GitForEng/syncbox/Design/Firmware/PIC24 Firmware/LCD Firmware/xaml design/XamlDesign/assets/actuator.jpg

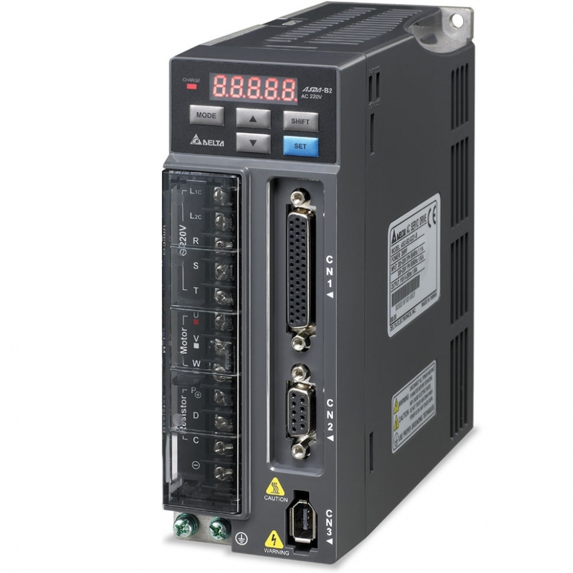
Design/Firmware/PIC24 Firmware/LCD Firmware/xaml design/XamlDesign/assets/actuator.jpg
