GitForEng/syncbox/Design/Firmware/PIC24 Firmware/documents/Doxygen/images/componentdiagram.png

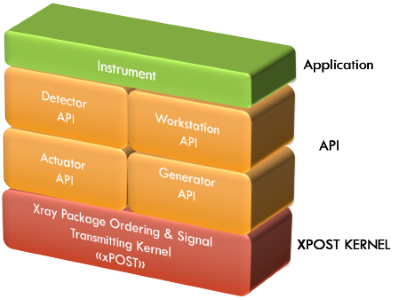
Design/Firmware/PIC24 Firmware/documents/Doxygen/images/componentdiagram.png
