GitForEng/syncbox/Design/SYNCBOX.PcbDoc.htm

Reporting Options

# File in Previous Format

Date | : | 4/13/2021
Time | : | 9:07:22 AM
Filename | : | D:\embedded_systems\Projects\BogaziciUniversity\syncbox\Design\SYNCBOX.PcbDoc

Version | Warning

This file was generated by an earlier version of the software
