GitForEng/syncbox/Artifacts/Reports/SyncBox/schematic.bmp

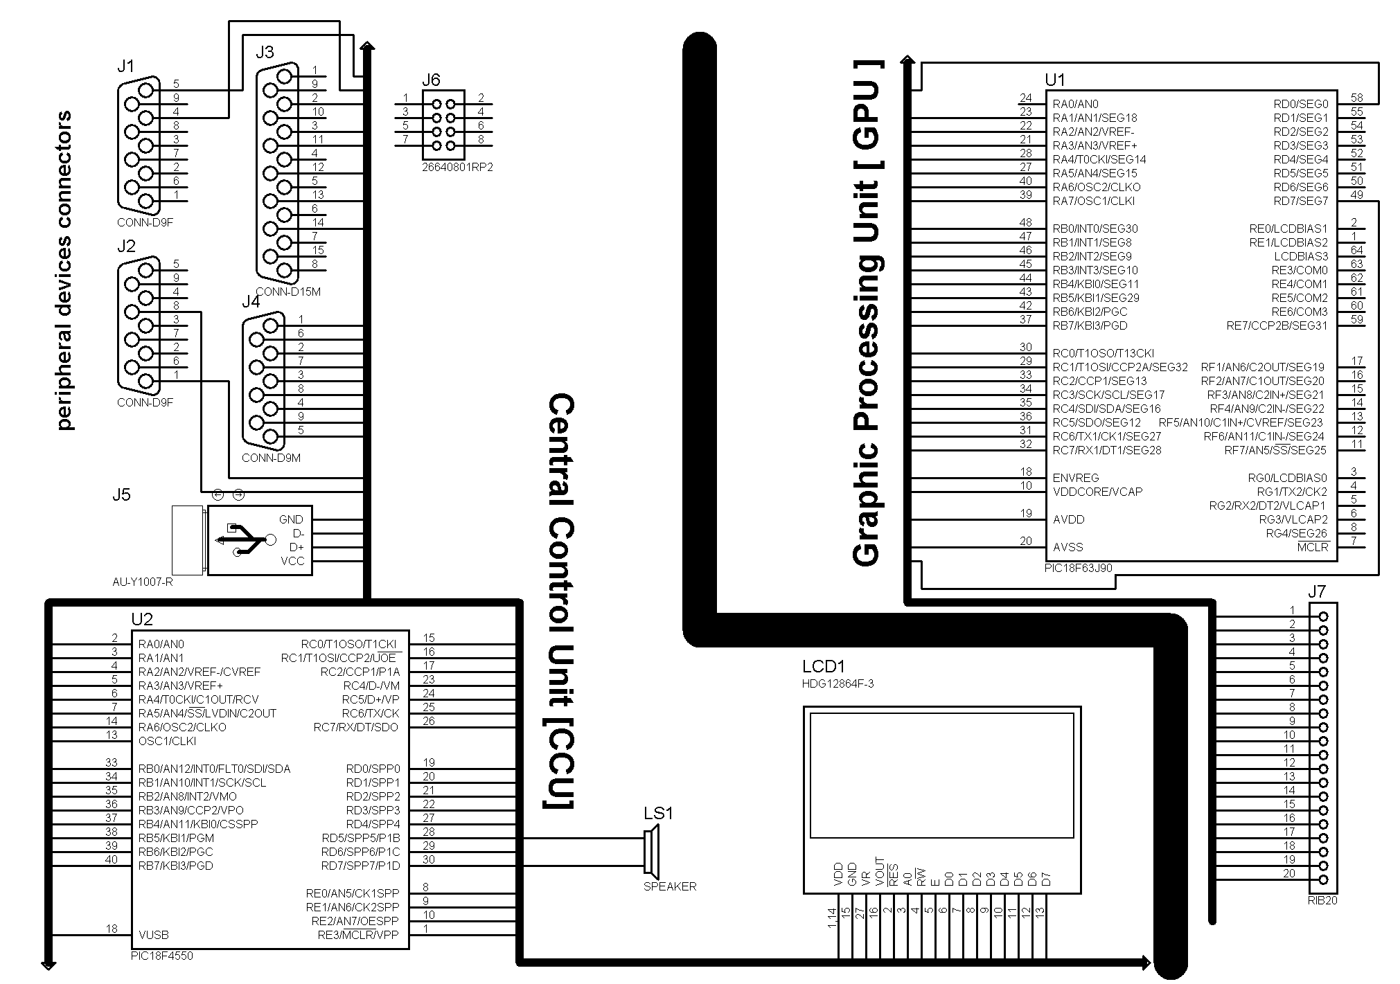
Artifacts/Reports/SyncBox/schematic.bmp
