GitForEng/syncbox/Artifacts/Reports/SyncBox/SyncBox Activity Diagram.jpg

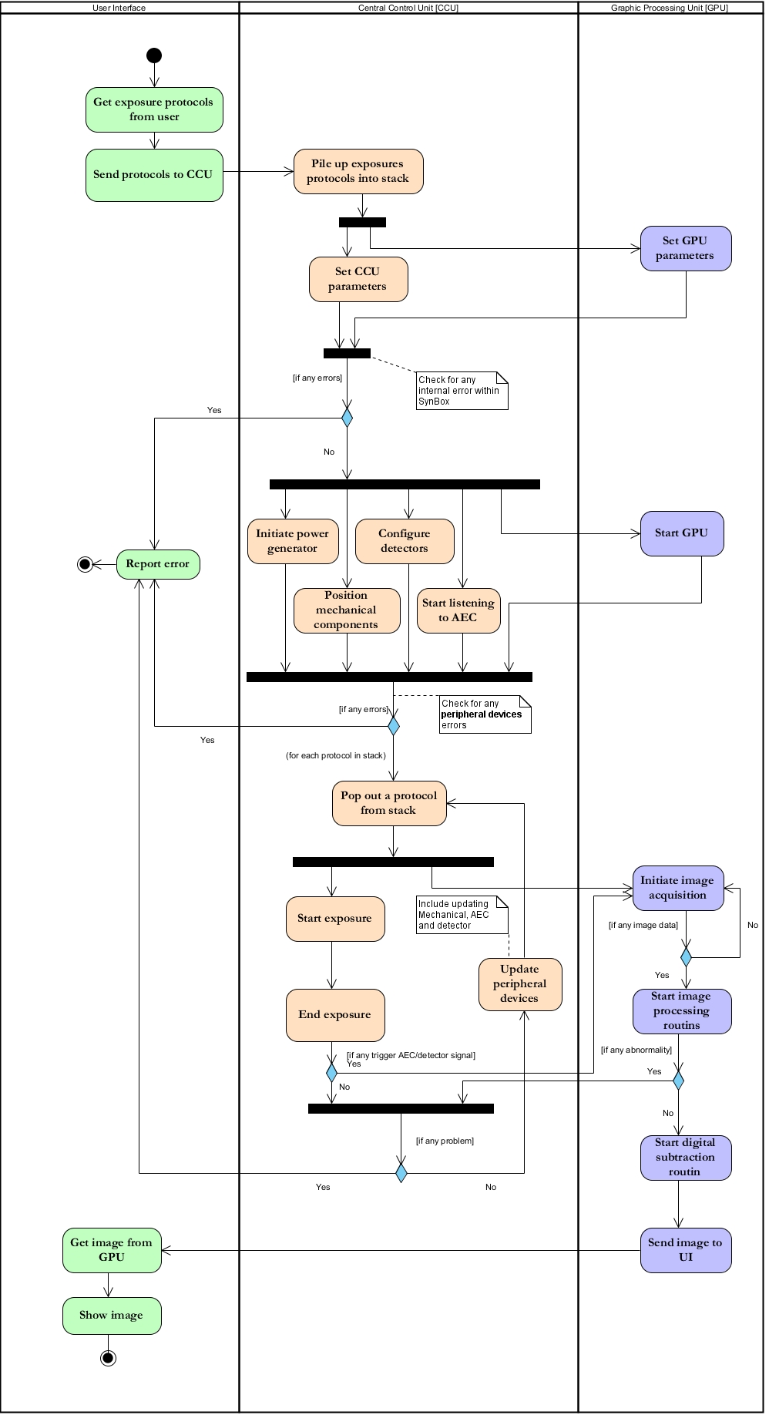
Artifacts/Reports/SyncBox/SyncBox Activity Diagram.jpg
