GitForEng/syncbox/Artifacts/Reports/SyncBox/SyncBox Sequence Diagram.jpg

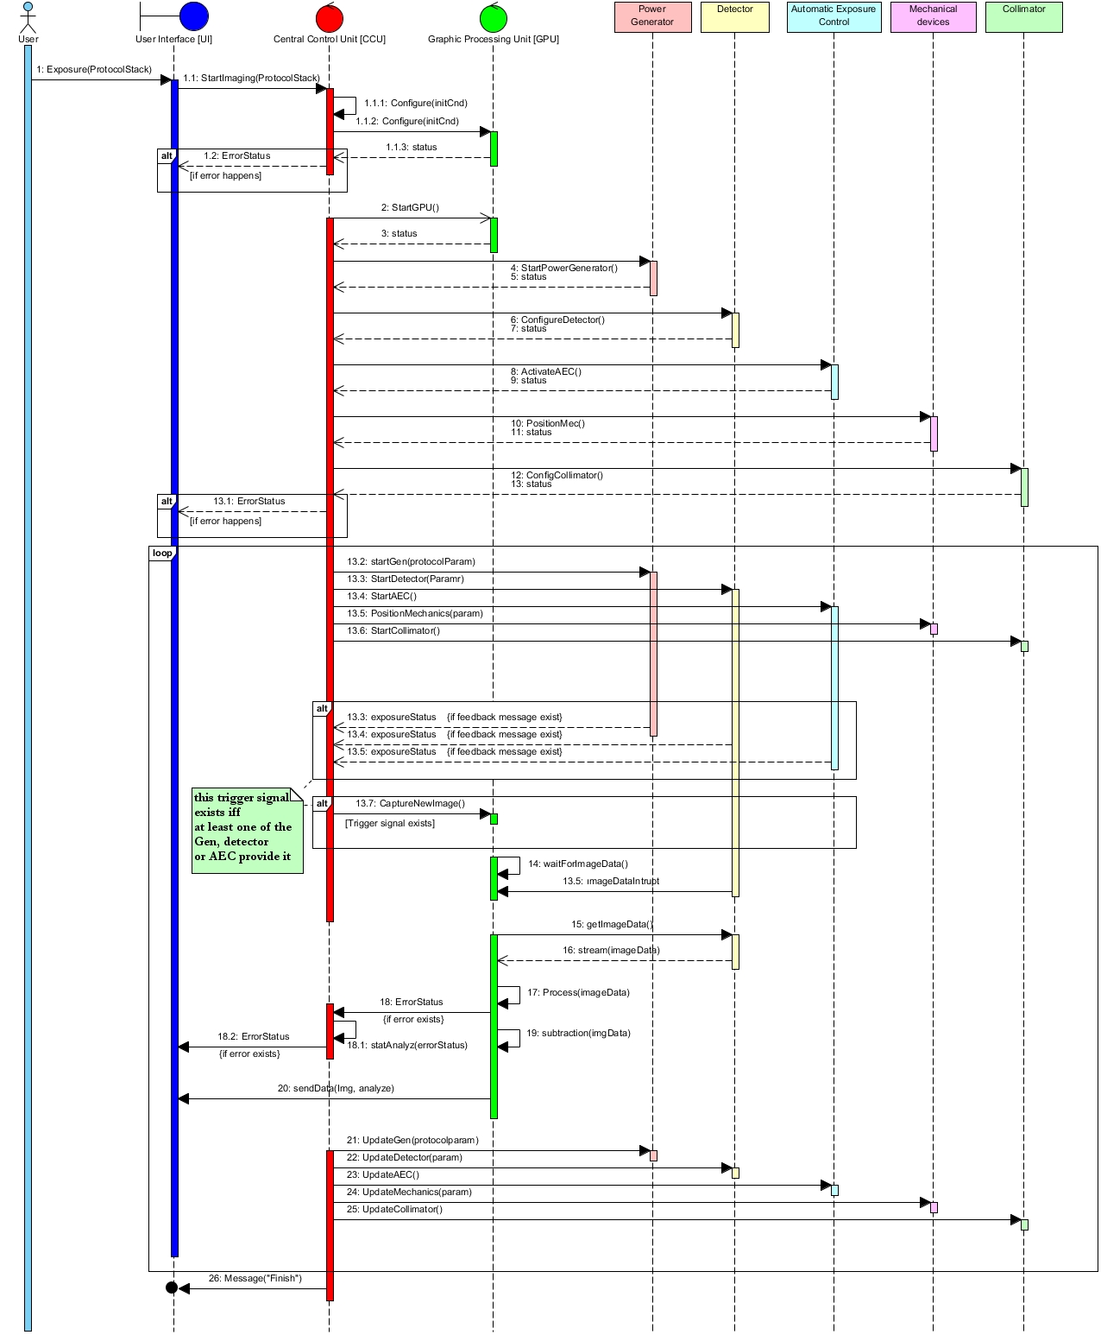
Artifacts/Reports/SyncBox/SyncBox Sequence Diagram.jpg
