GitForEng/syncbox/Design/Firmware/PIC24 Firmware/documents/docbook/_connection_map_8h__dep__incl.png

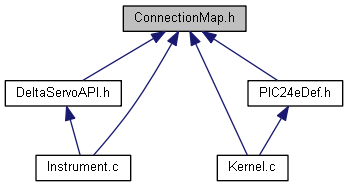
Design/Firmware/PIC24 Firmware/documents/docbook/_connection_map_8h__dep__incl.png
