GitForEng/syncbox/Design/Firmware/PIC24 Firmware/documents/docbook/_delta_servo_a_p_i_8c__incl.png

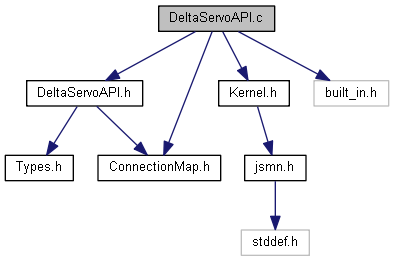
Design/Firmware/PIC24 Firmware/documents/docbook/_delta_servo_a_p_i_8c__incl.png
