GitForEng/syncbox/Design/Firmware/PIC24 Firmware/documents/docbook/_instrument_8c__incl.png

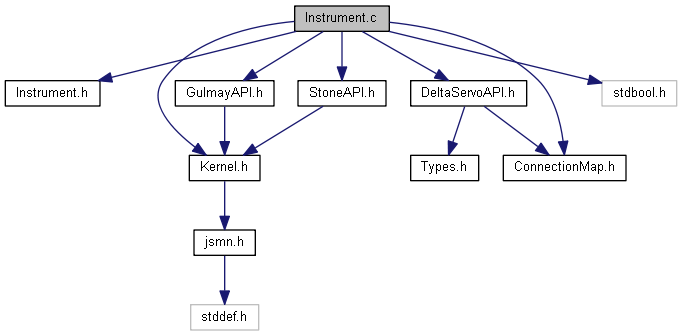
Design/Firmware/PIC24 Firmware/documents/docbook/_instrument_8c__incl.png
