GitForEng/syncbox/Design/Firmware/PIC24 Firmware/documents/docbook/_kernel_8c__incl.png

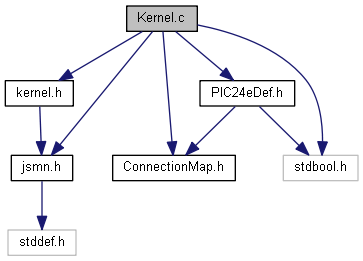
Design/Firmware/PIC24 Firmware/documents/docbook/_kernel_8c__incl.png
