GitForEng/syncbox/Design/Firmware/PIC24 Firmware/documents/docbook/_types_8h__dep__incl.png

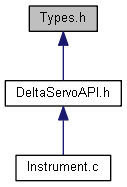
Design/Firmware/PIC24 Firmware/documents/docbook/_types_8h__dep__incl.png
