GitForEng/syncbox/Design/Firmware/PIC24 Firmware/documents/docbook/jsmn_8h__dep__incl.png

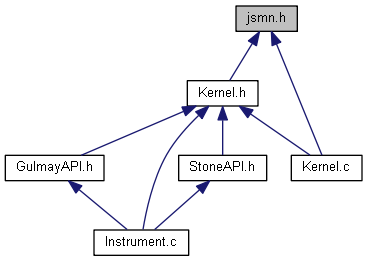
Design/Firmware/PIC24 Firmware/documents/docbook/jsmn_8h__dep__incl.png
