GitForEng/syncbox/Design/Firmware/PIC24 Firmware/documents/docbook/main_8c__incl.png

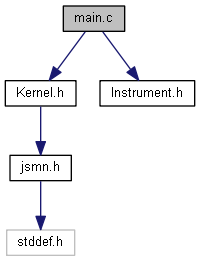
Design/Firmware/PIC24 Firmware/documents/docbook/main_8c__incl.png
