GitForEng/syncbox/Design/Firmware/PIC24 Firmware/documents/docbook/struct_d_e_v_i_c_e___s_l_o_t__coll__graph.png

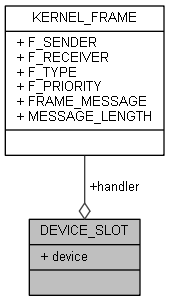
Design/Firmware/PIC24 Firmware/documents/docbook/struct_d_e_v_i_c_e___s_l_o_t__coll__graph.png
