GitForEng/syncbox/Design/Firmware/PIC24 Firmware/documents/docbook/struct_g_e_n___s_t_a_t_e__coll__graph.png

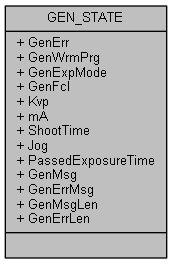
Design/Firmware/PIC24 Firmware/documents/docbook/struct_g_e_n___s_t_a_t_e__coll__graph.png
