GitForEng/syncbox/Design/Firmware/PIC24 Firmware/documents/docbook/struct_k_e_r_n_e_l___f_r_a_m_e__coll__graph.png

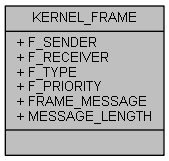
Design/Firmware/PIC24 Firmware/documents/docbook/struct_k_e_r_n_e_l___f_r_a_m_e__coll__graph.png
