GitForEng/syncbox/Design/Firmware/PIC24 Firmware/documents/docbook/tst_instrument_8c__incl.png

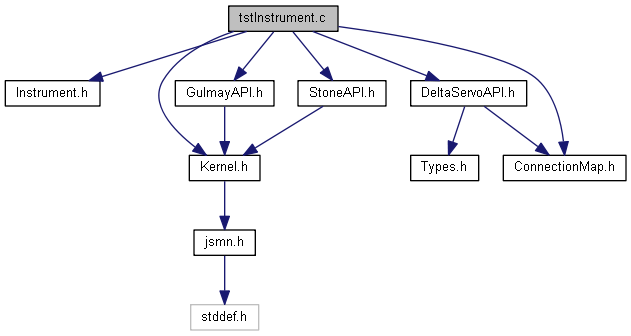
Design/Firmware/PIC24 Firmware/documents/docbook/tst_instrument_8c__incl.png
