GitForEng/syncbox/Design/Firmware/PIC24 Firmware/documents/Doxygen/html/graph_legend.png

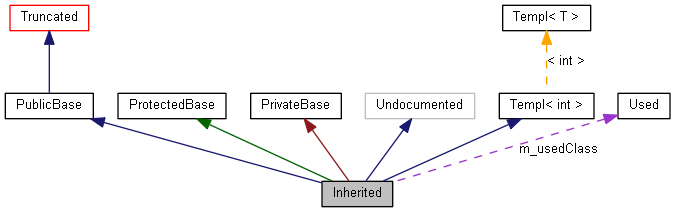
Design/Firmware/PIC24 Firmware/documents/Doxygen/html/graph_legend.png
