GitForEng/syncbox/Design/Firmware/PIC24 Firmware/documents/visual paradigm/pictures/Bootup Activity Diagram.jpg

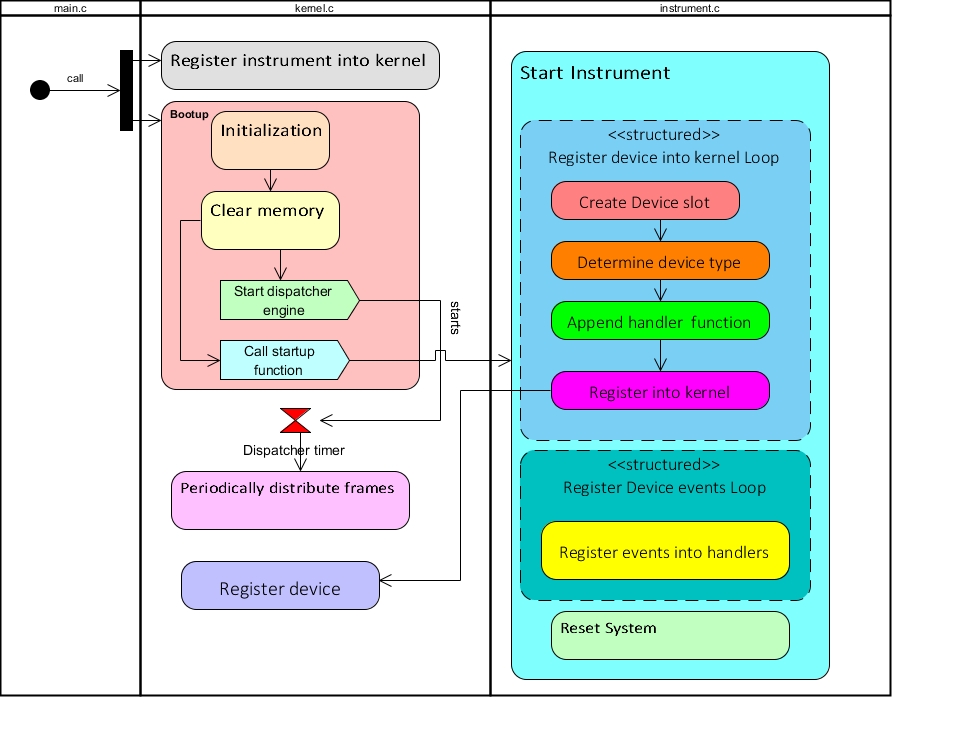
Design/Firmware/PIC24 Firmware/documents/visual paradigm/pictures/Bootup Activity Diagram.jpg
