GitForEng/syncbox/Design/Firmware/PIC24 Firmware/documents/visual paradigm/pictures/Button Pressed Communication Diagram.jpg

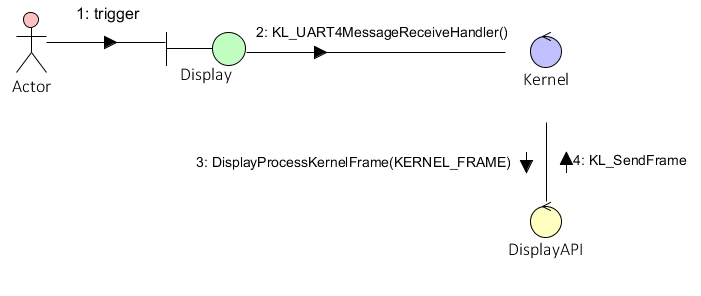
Design/Firmware/PIC24 Firmware/documents/visual paradigm/pictures/Button Pressed Communication Diagram.jpg
