GitForEng/syncbox/Design/Firmware/PIC24 Firmware/documents/visual paradigm/pictures/Instrument Feedback Communication  Diagram.jpg

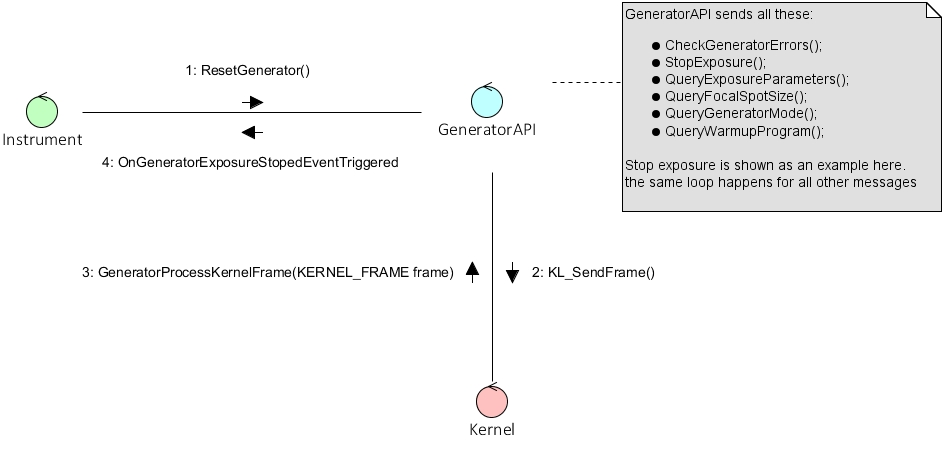
Design/Firmware/PIC24 Firmware/documents/visual paradigm/pictures/Instrument Feedback Communication Diagram.jpg
