GitForEng/syncbox/Design/Firmware/PIC24 Firmware/documents/visual paradigm/pictures/Instrument Start Exposure Activity Diagram.jpg

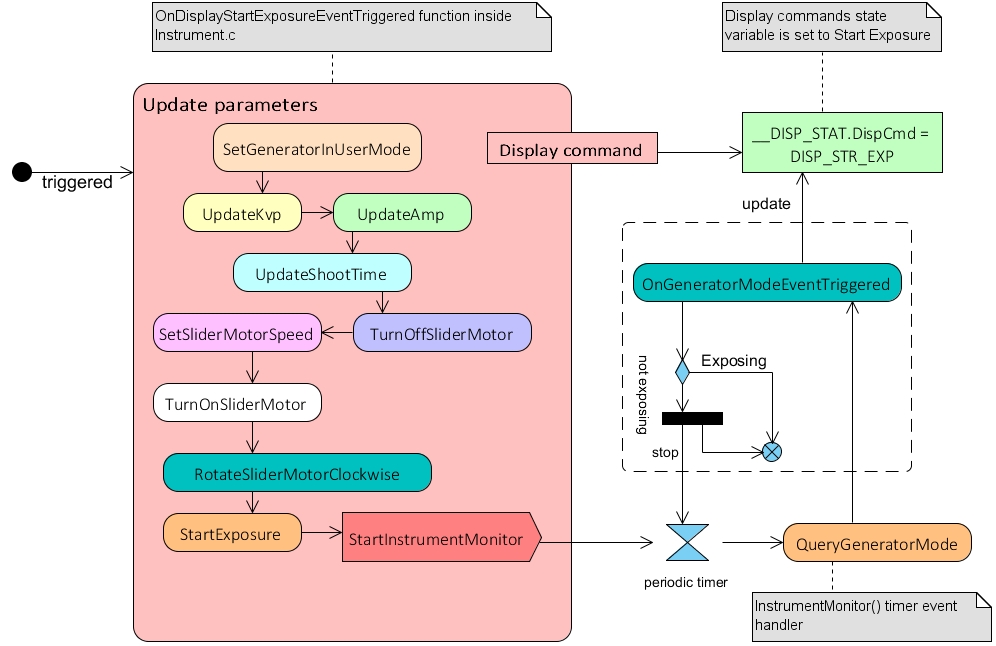
Design/Firmware/PIC24 Firmware/documents/visual paradigm/pictures/Instrument Start Exposure Activity Diagram.jpg
