GitForEng/syncbox/Design/Firmware/PIC24 Firmware/documents/visual paradigm/pictures/Instrument State Diagram.jpg

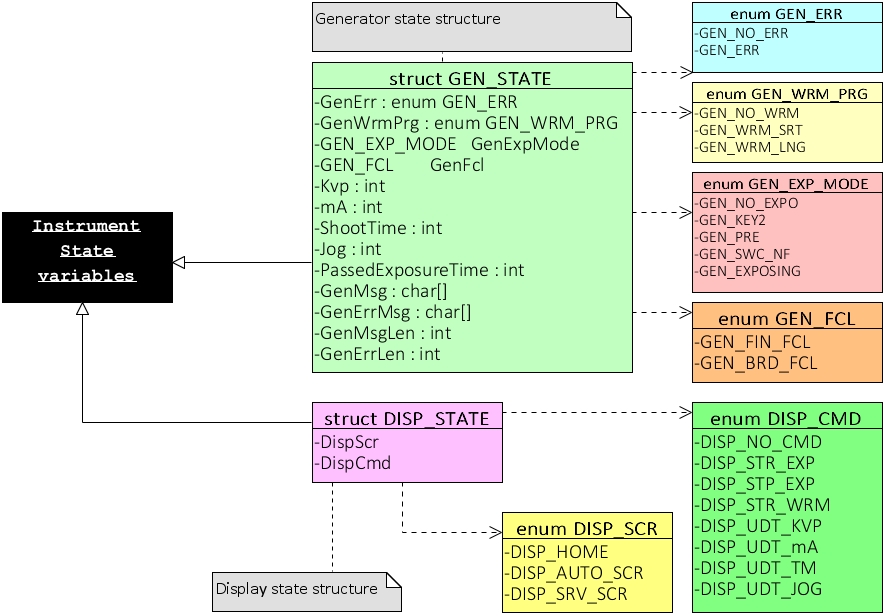
Design/Firmware/PIC24 Firmware/documents/visual paradigm/pictures/Instrument State Diagram.jpg
