GitForEng/syncbox/Design/Firmware/PIC24 Firmware/documents/visual paradigm/pictures/Start Exposure Sequence Diagram.jpg

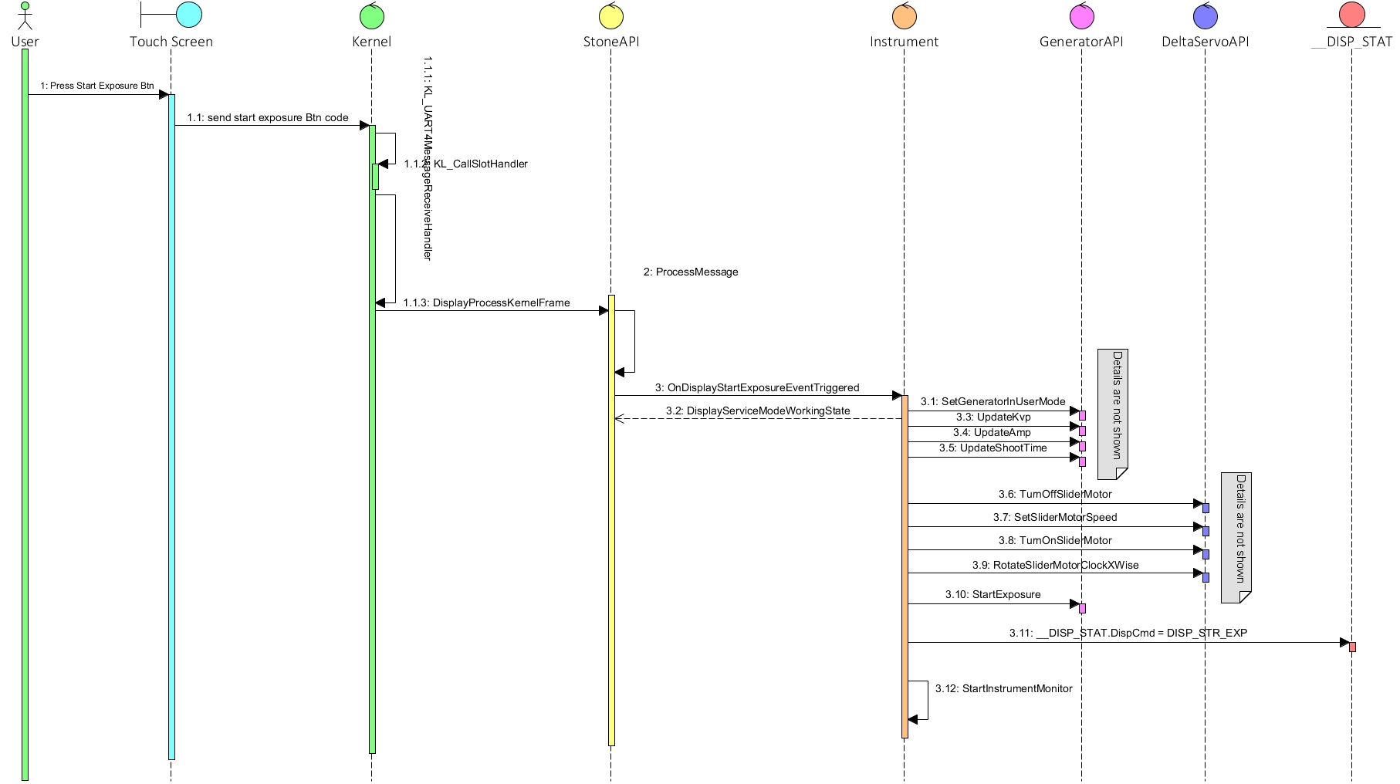
Design/Firmware/PIC24 Firmware/documents/visual paradigm/pictures/Start Exposure Sequence Diagram.jpg
