GitForEng/syncbox/Design/Firmware/PIC24 Firmware/firmware/easypic-fusion-v7-pic24ep512gu810-thickbox_default-12x.jpg

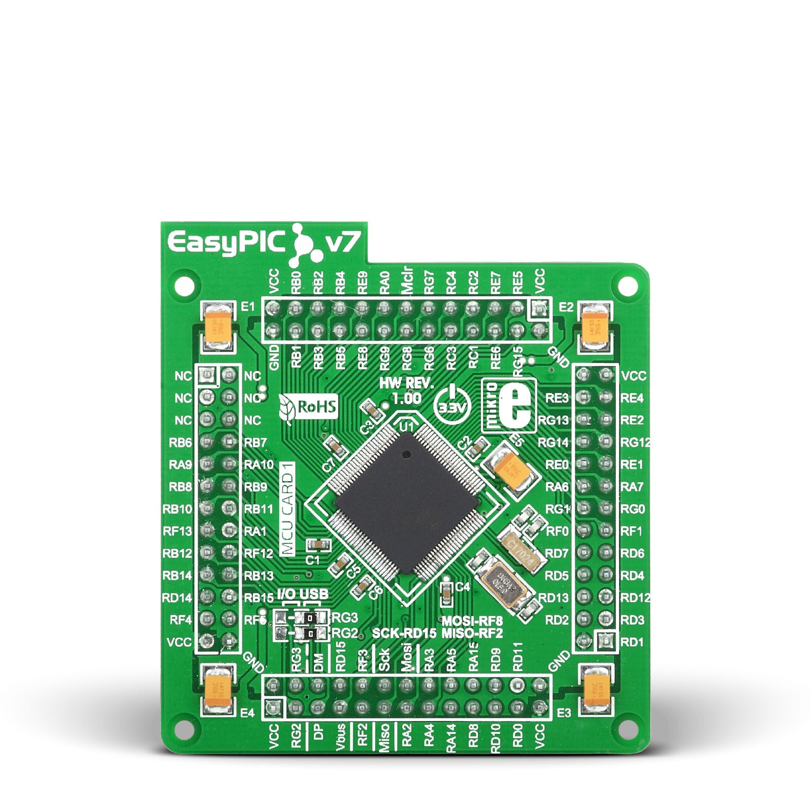
Design/Firmware/PIC24 Firmware/firmware/easypic-fusion-v7-pic24ep512gu810-thickbox_default-12x.jpg
