GitForEng/syncbox/Design/Firmware/PIC24 Firmware/firmware/json-parser-functioncall.JPG

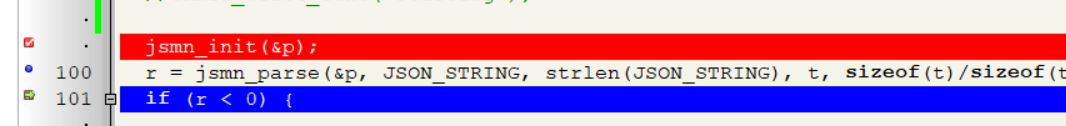
Design/Firmware/PIC24 Firmware/firmware/json-parser-functioncall.JPG
