GitForEng/syncbox/Design/Firmware/PIC24 Firmware/firmware/PIC24E_Pinout.png

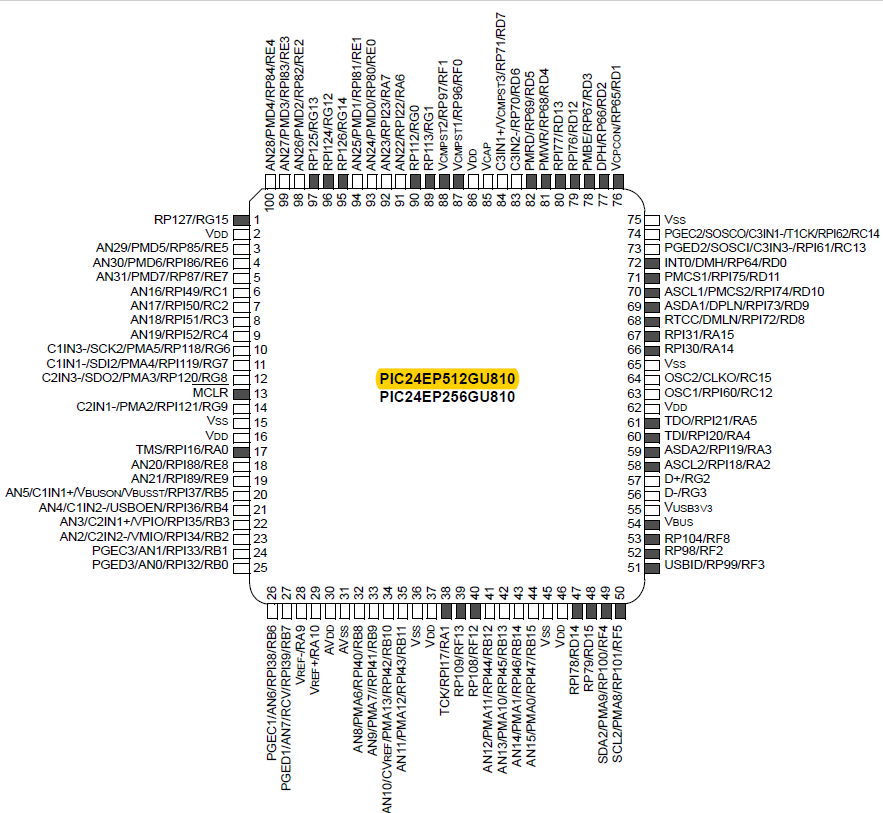
Design/Firmware/PIC24 Firmware/firmware/PIC24E_Pinout.png
