GitForEng/syncbox/Design/Firmware/PIC24 Firmware/firmware/project-config-screenshot.JPG

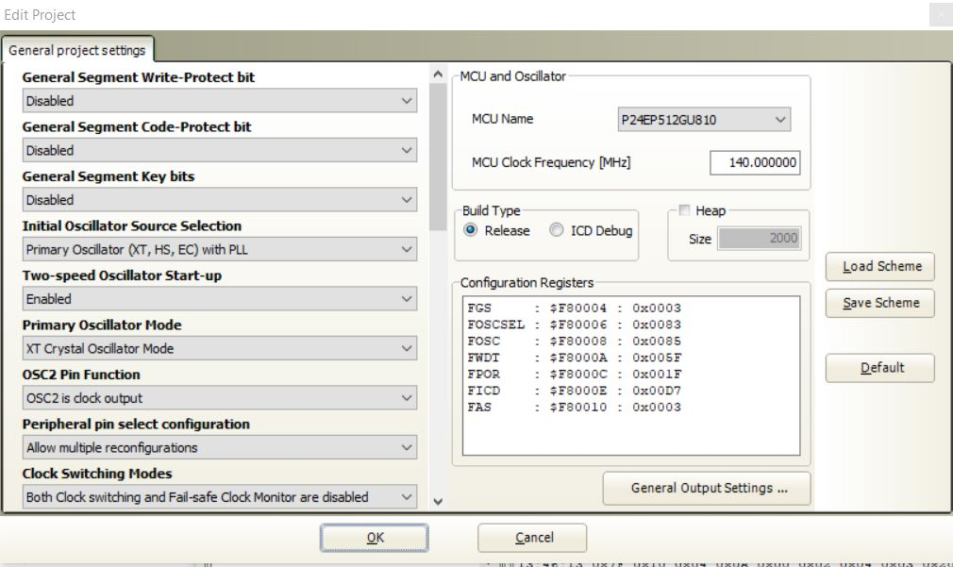
Design/Firmware/PIC24 Firmware/firmware/project-config-screenshot.JPG
