GitForEng/syncbox/Design/Firmware/PIC24 Firmware/LCD Firmware/project/00.bmp

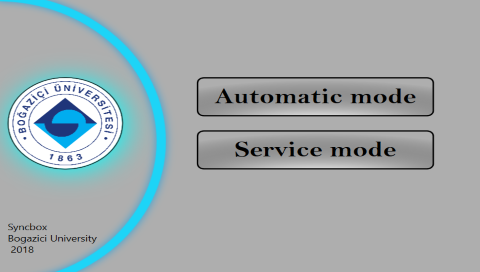
Design/Firmware/PIC24 Firmware/LCD Firmware/project/00.bmp
