GitForEng/syncbox/Design/Firmware/PIC24 Firmware/LCD Firmware/project/01.bmp

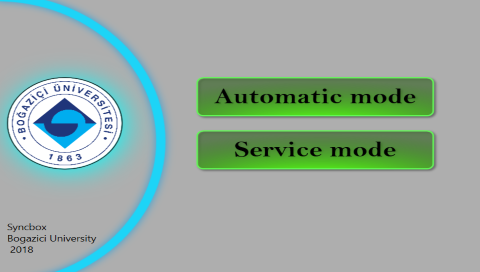
Design/Firmware/PIC24 Firmware/LCD Firmware/project/01.bmp
