GitForEng/syncbox/Design/Firmware/PIC24 Firmware/LCD Firmware/project/02.bmp

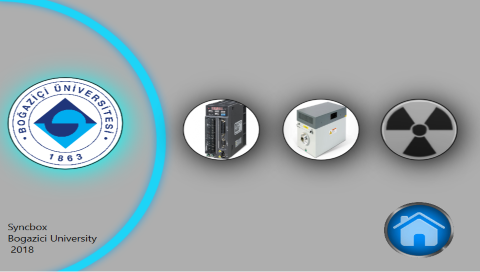
Design/Firmware/PIC24 Firmware/LCD Firmware/project/02.bmp
