GitForEng/syncbox/Design/Firmware/PIC24 Firmware/LCD Firmware/project/04.bmp

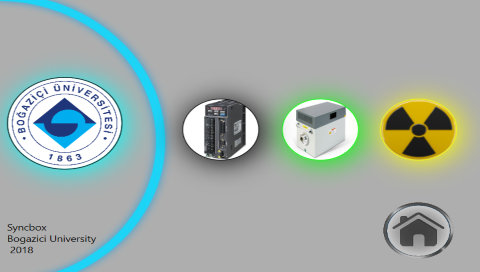
Design/Firmware/PIC24 Firmware/LCD Firmware/project/04.bmp
