GitForEng/syncbox/Design/Firmware/PIC24 Firmware/LCD Firmware/project/06.bmp

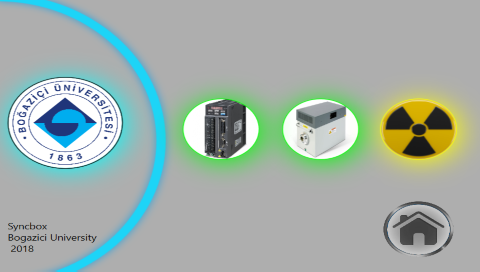
Design/Firmware/PIC24 Firmware/LCD Firmware/project/06.bmp
