GitForEng/syncbox/Design/Firmware/PIC24 Firmware/LCD Firmware/project/07.bmp

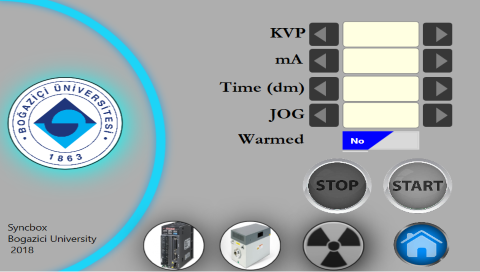
Design/Firmware/PIC24 Firmware/LCD Firmware/project/07.bmp
