GitForEng/syncbox/Design/Firmware/PIC24 Firmware/LCD Firmware/project/10.bmp

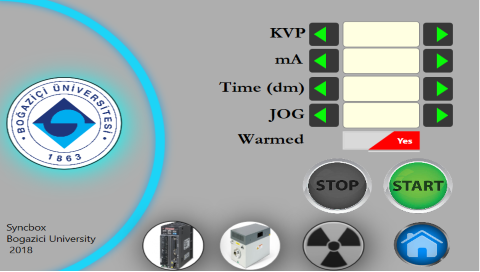
Design/Firmware/PIC24 Firmware/LCD Firmware/project/10.bmp
