GitForEng/syncbox/Design/Firmware/PIC24 Firmware/LCD Firmware/xaml design/XamlDesign/assets/bu.png

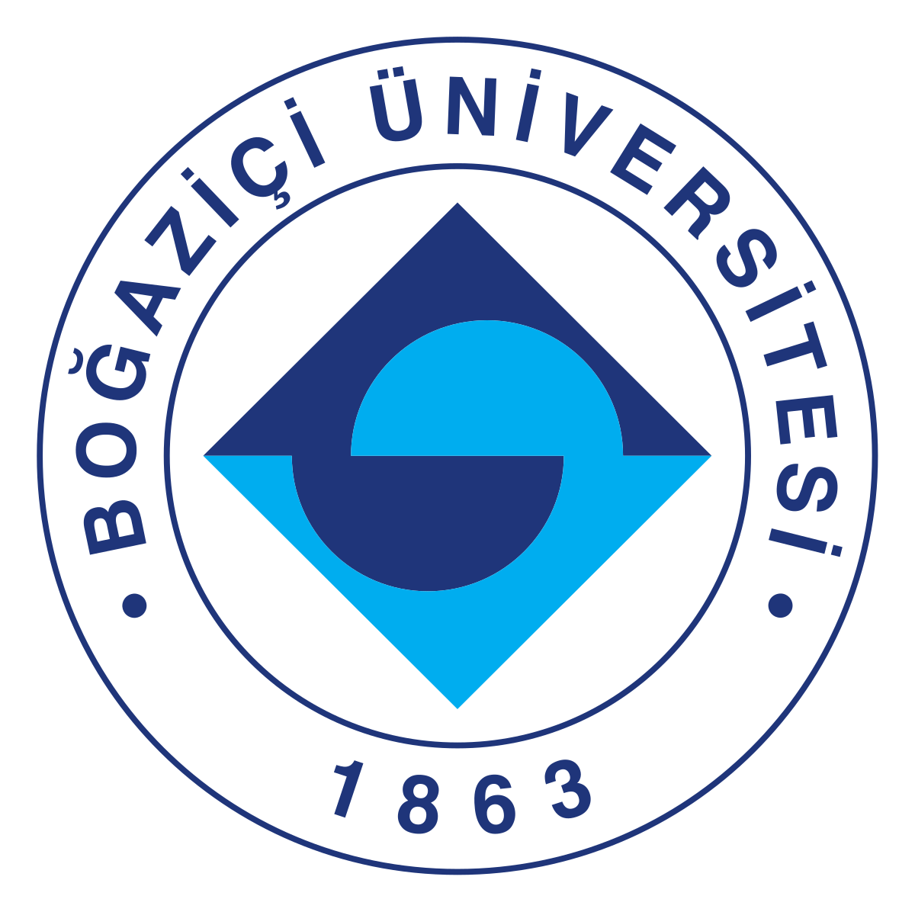
Design/Firmware/PIC24 Firmware/LCD Firmware/xaml design/XamlDesign/assets/bu.png
