GitForEng/syncbox/Design/Firmware/PIC24 Firmware/LCD Firmware/xaml design/XamlDesign/assets/detector.jpg

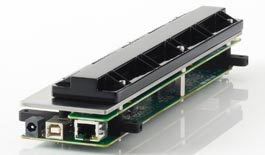
Design/Firmware/PIC24 Firmware/LCD Firmware/xaml design/XamlDesign/assets/detector.jpg
