GitForEng/syncbox/Design/Firmware/PIC24 Firmware/LCD Firmware/xaml design/XamlDesign/assets/generator.jpg

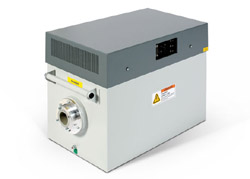
Design/Firmware/PIC24 Firmware/LCD Firmware/xaml design/XamlDesign/assets/generator.jpg
