GitForEng/syncbox/Design/Firmware/PIC24 Firmware/LCD Firmware/xaml design/XamlDesign/Resources/diactivehome.png

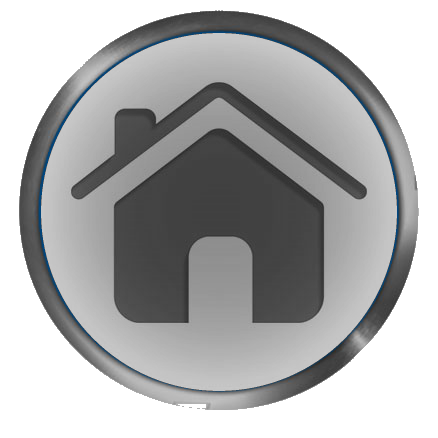
Design/Firmware/PIC24 Firmware/LCD Firmware/xaml design/XamlDesign/Resources/diactivehome.png
