GitForEng/syncbox/Design/Firmware/PIC24 Firmware/LCD Firmware/xaml design/XamlDesign/Resources/diactivestart.png

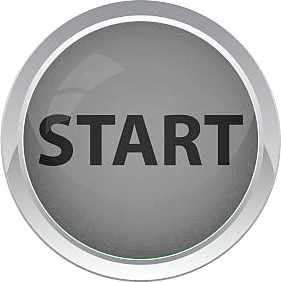
Design/Firmware/PIC24 Firmware/LCD Firmware/xaml design/XamlDesign/Resources/diactivestart.png
