GitForEng/syncbox/Design/Firmware/PIC24 Firmware/LCD Firmware/xaml design/XamlDesign/Resources/diactivestop.png

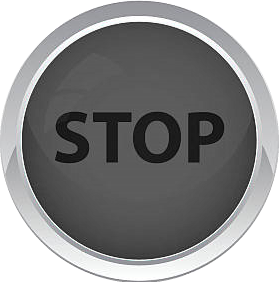
Design/Firmware/PIC24 Firmware/LCD Firmware/xaml design/XamlDesign/Resources/diactivestop.png
