GitForEng/syncbox/Design/Firmware/PIC24 Firmware/LCD Firmware/xaml design/XamlDesign/Resources/home.png

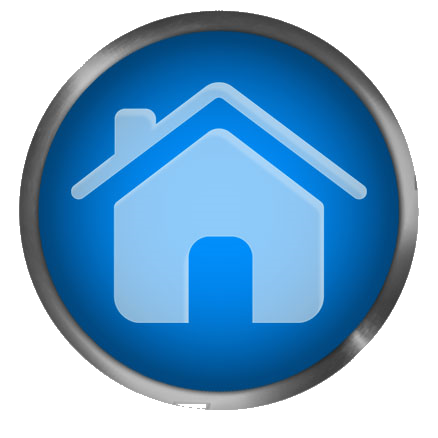
Design/Firmware/PIC24 Firmware/LCD Firmware/xaml design/XamlDesign/Resources/home.png
