GitForEng/syncbox/Design/Firmware/PIC24 Firmware/LCD Firmware/xaml design/XamlDesign/Resources/start.jpg

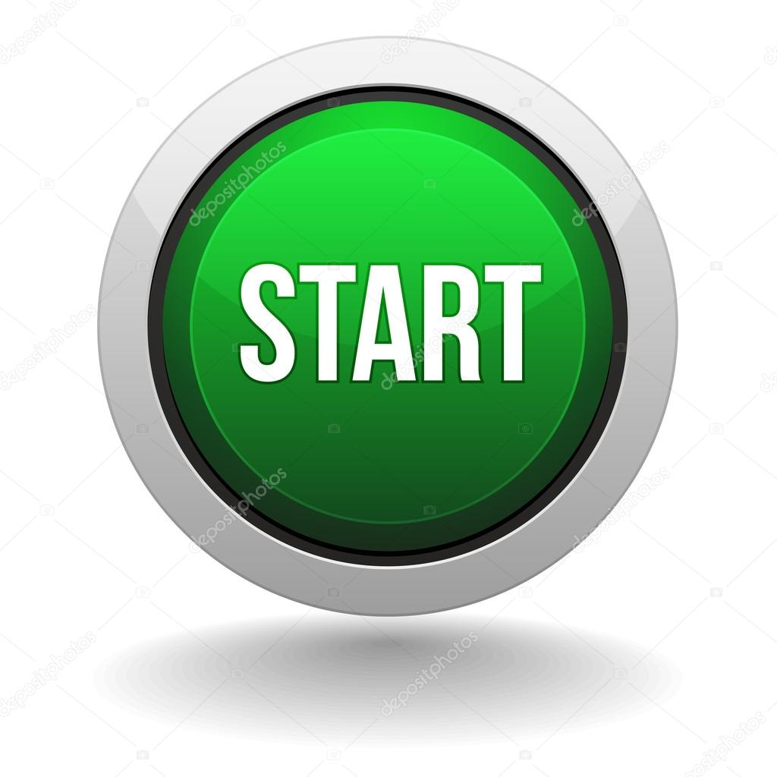
Design/Firmware/PIC24 Firmware/LCD Firmware/xaml design/XamlDesign/Resources/start.jpg
