GitForEng/syncbox/Design/SMASeries.stp

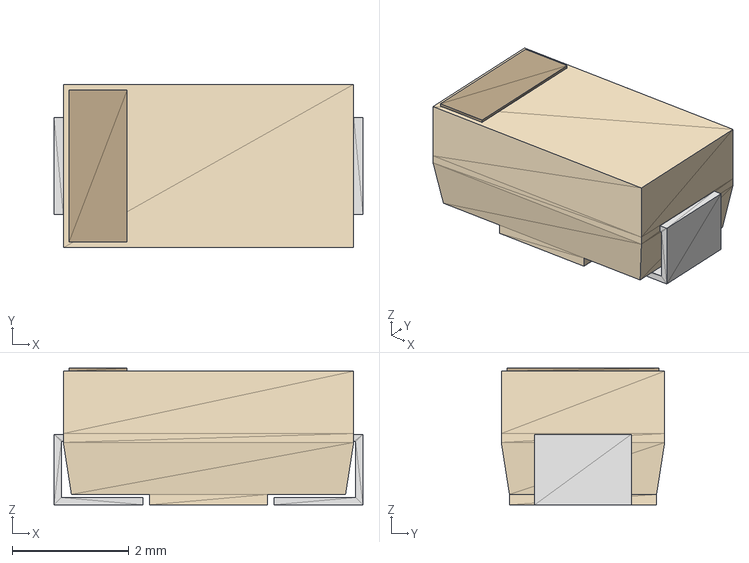
[picture p55: CAD file, 2022-01-23]
Design/SMASeries.stp
5.28 x 2.79 x 2.34 mm
