GitForEng/syncbox/Artifacts/Design Guides/iMX6 Rex Module V1I1 PCB STACKUP.pdf

StackName: iMX6_Rex_V1I1_PCB_12L_VT47_mv | Version: 1 | Revision: | Modification: | Date of Revision: | Editor | Page 1/3
Date: 31/10/2013 | Associated Documents:

Author: DM
Department: IDS
Site: Tewkesbury

Copyright ©

www.polarinstruments.com

Soldermask | 0.020 | SolderMask | 4.100 | 10
1 | Foil | 1, 2, 3 | 0.012 | 0.035 | Foil | 0
VT47-1080 | 0.075 | 0.075 | PREPREG | 4.000
2 | Foil | | 0.009 | 0.032 | Foil | 0
VT47-106 | 0.053 | 0.053 | PREPREG | 4.000
VT47-106 | 0.053 | 0.053 | PREPREG | 4.000
3 | | 4, 5, 6 | 0.018 | 0.035
VT-47 | 0.203 | 0.203 | Core | 4.600
4 | | | 0.018 | 0.018
VT47-2113 | 0.096 | 0.096 | PREPREG | 4.000
5 | | | 0.018 | 0.018
VT-47 | 0.102 | 0.102 | Core | 4.120
6 | | | 0.018 | 0.018
VT47-106 | 0.053 | 0.053 | PREPREG | 4.000
VT47-106 | 0.053 | 0.053 | PREPREG | 4.000
7 | | | 0.018 | 0.018
VT-47 | 0.102 | 0.102 | Core | 4.120
8 | | | 0.018 | 0.018
VT47-2113 | 0.096 | 0.096 | PREPREG | 4.000
9 | | | 0.018 | 0.018
VT-47 | 0.203 | 0.203 | Core | 4.600
10 | | 7, 8, 9 | 0.018 | 0.035
VT47-106 | 0.053 | 0.053 | PREPREG | 4.000
VT47-106 | 0.053 | 0.053 | PREPREG | 4.000
11 | Foil | | 0.009 | 0.032 | Foil | 0
VT47-1080 | 0.075 | 0.075 | PREPREG | 4.000
12 | Foil | 10, 11, 12 | 0.012 | 0.035 | Foil | 0
Soldermask | 0.020 | SolderMask | 4.100 | 10

1.6 +0.0 / -0.0

1 | Coated Microstrip 1B | 1 | 2 | 0 | 0.093 | 0.000 | 0.000 | 55.000 | 55.060 | 10.000
2 | Edge Coupled Coated Microstrip 1B | 1 | 2 | 0 | 0.101 | 0.114 | 0.000 | 90.000 | 90.060 | 10.000
3 | Edge Coupled Coated Microstrip 1B | 1 | 2 | 0 | 0.090 | 0.160 | 0.000 | 100.000 | 100.300 | 10.000
4 | Offset Stripline 1B1A | 3 | 2 | 4 | 0.080 | 0.000 | 0.000 | 55.000 | 53.620 | 10.000

StackName: iMX6_Rex_V1I1_PCB_12L_VT47_mv | Version: 1 | Revision: | Modification: | Date of Revision: | Editor | Page 2/3
Date: 31/10/2013 | Associated Documents:

Author: DM

5 | Edge Coupled Offset Stripline 1B1A | 3 | 2 | 4 | 0.085 | 0.115 | 0.000 | 90.000 | 88.390 | 10.000
6 | Edge Coupled Offset Stripline 1B1A | 3 | 2 | 4 | 0.085 | 0.195 | 0.000 | 100.000 | 98.390 | 10.000
7 | Offset Stripline 1B1A | 10 | 9 | 11 | 0.080 | 0.000 | 0.000 | 55.000 | 53.620 | 10.000
8 | Edge Coupled Offset Stripline 1B1A | 10 | 9 | 11 | 0.085 | 0.115 | 0.000 | 90.000 | 88.390 | 10.000
9 | Edge Coupled Offset Stripline 1B1A | 10 | 9 | 11 | 0.085 | 0.195 | 0.000 | 100.000 | 98.390 | 10.000
10 | Coated Microstrip 1B | 12 | 11 | 0 | 0.093 | 0.000 | 0.000 | 55.000 | 55.060 | 10.000
11 | Edge Coupled Coated Microstrip 1B | 12 | 11 | 0 | 0.101 | 0.114 | 0.000 | 90.000 | 90.060 | 10.000
12 | Edge Coupled Coated Microstrip 1B | 12 | 11 | 0 | 0.090 | 0.160 | 0.000 | 100.000 | 100.300 | 10.000
1 | 12 | Mechanical PTH | 0.000 | None
1 | 2 | Laser PTH | 0.100 | None
2 | 3 | Laser PTH | 0.100 | None
12 | 11 | Laser PTH | 0.100 | None
11 | 10 | Laser PTH | 0.100 | None

StackName: iMX6_Rex_V1I1_PCB_12L_VT47_mv | Version: 1 | Revision: | Modification: | Date of Revision: | Editor | Page 3/3
Date: 31/10/2013 | Associated Documents:

Author: DM

3 | 10 | Mechanical PTH | 0.200 | None
