GitForEng/syncbox/Artifacts/Design Guides/Serial port wiring.png

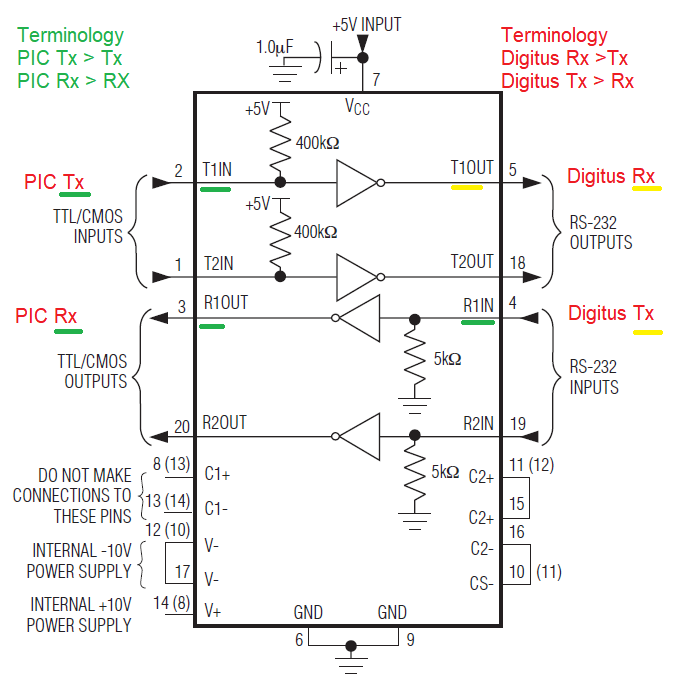
Artifacts/Design Guides/Serial port wiring.png
