GitForEng/syncbox/Design/Firmware/PIC24 Firmware/firmware/jsonparser_performance.JPG

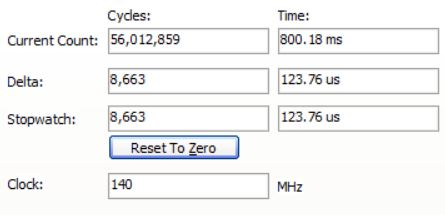
Design/Firmware/PIC24 Firmware/firmware/jsonparser_performance.JPG
