GitForEng/syncbox/Artifacts/Design Guides/schematics/GALILEO.pdf

# GALILEO

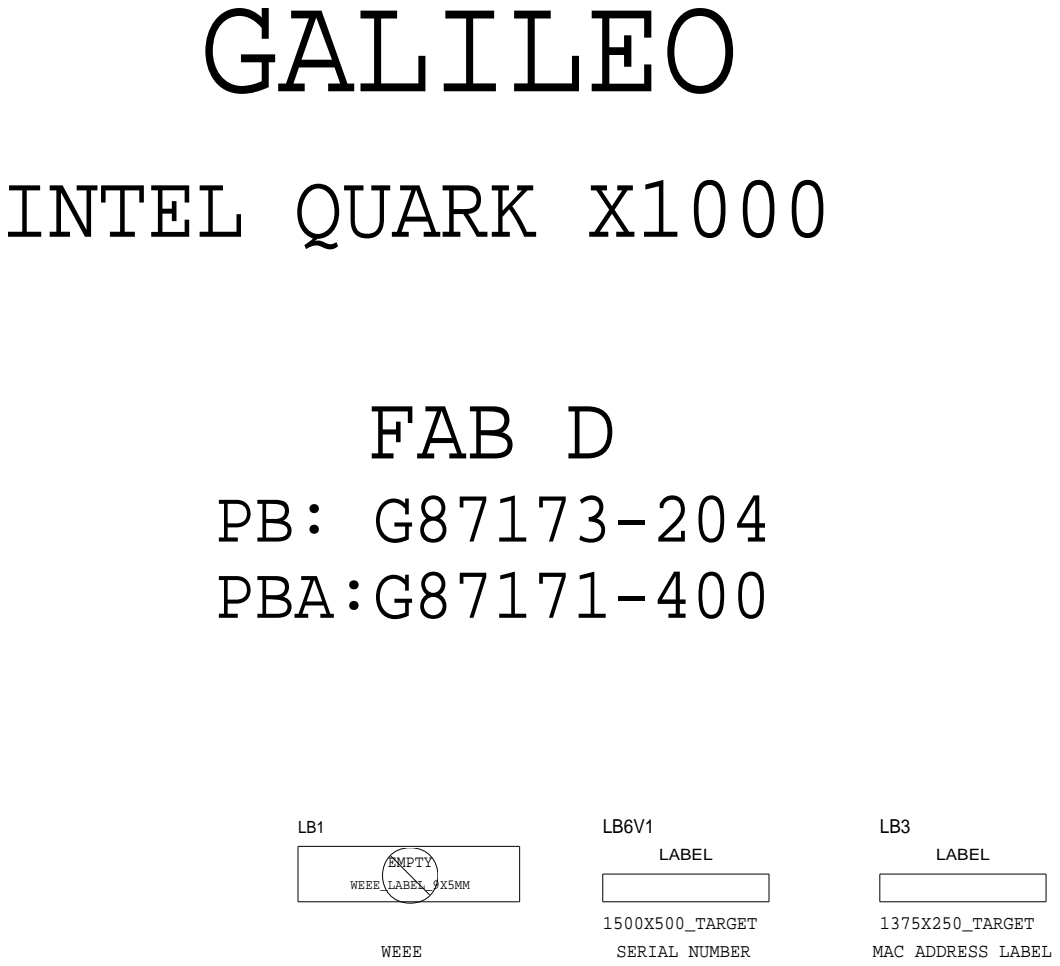
[picture p63: page 1]
INTEL QUARK X1000; PB: G87173-204 PBA:G87171-400; WEEE; SERIAL NUMBER; MAC ADDRESS LABEL; FAB D; 1500X500_TARGET; 1375X250_TARGET; WEEE_LABEL_9X5MM; EMPTY; LABEL; Order Number: 329682-001US

REVISION HISTORY

ZONE | REV | DESCRIPTION | DATE | APPROVED

DRAWN BY | DATE | INTEL CORPORATION 2111 NE 25TH AVENUE HILLSBORO OR 97124

APPROVED BY | DATE

TITLE GALILEO | DOCUMENT NUMBER G87171 | REV 1.0

SHEET 1 OF 27

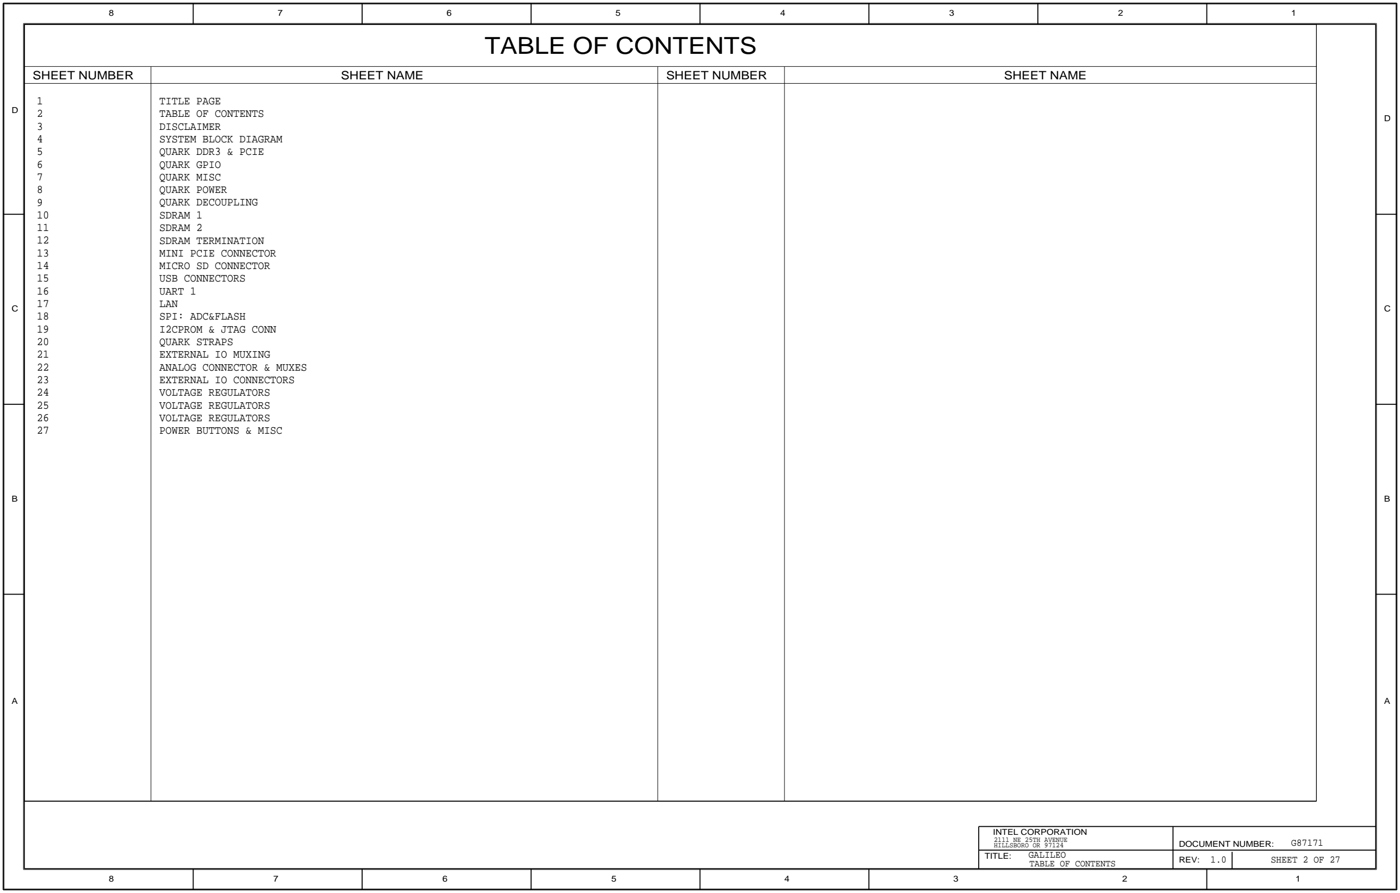
[picture p64: figure]
TITLE: TABLE OF CONTENTS; 1.0 REV:; SHEET 2 OF 27; SHEET NUMBER; SHEET NAME; TABLE OF CONTENTS; SYSTEM BLOCK DIAGRAM; POWER BUTTONS & MISC; VOLTAGE REGULATORS; EXTERNAL IO CONNECTORS; ANALOG CONNECTOR & MUXES; EXTERNAL IO MUXING; QUARK STRAPS; I2CPROM & JTAG CONN; SPI: ADC&FLASH; LAN; USB CONNECTORS; QUARK DDR3 & PCIE; SDRAM 2 SDRAM TERMINATION MINI PCIE CONNECTOR; UART 1; MICRO SD CONNECTOR; SDRAM 1; QUARK DECOUPLING; QUARK POWER; QUARK MISC; QUARK GPIO; DISCLAIMER; TITLE PAGE

INTEL CORPORATION 2111 NE 25TH AVENUE HILLSBORO OR 97124 | DOCUMENT NUMBER: G87171

INTEL CORPORATION

### DISCLAIMER

D

D

AB

A

CB

C

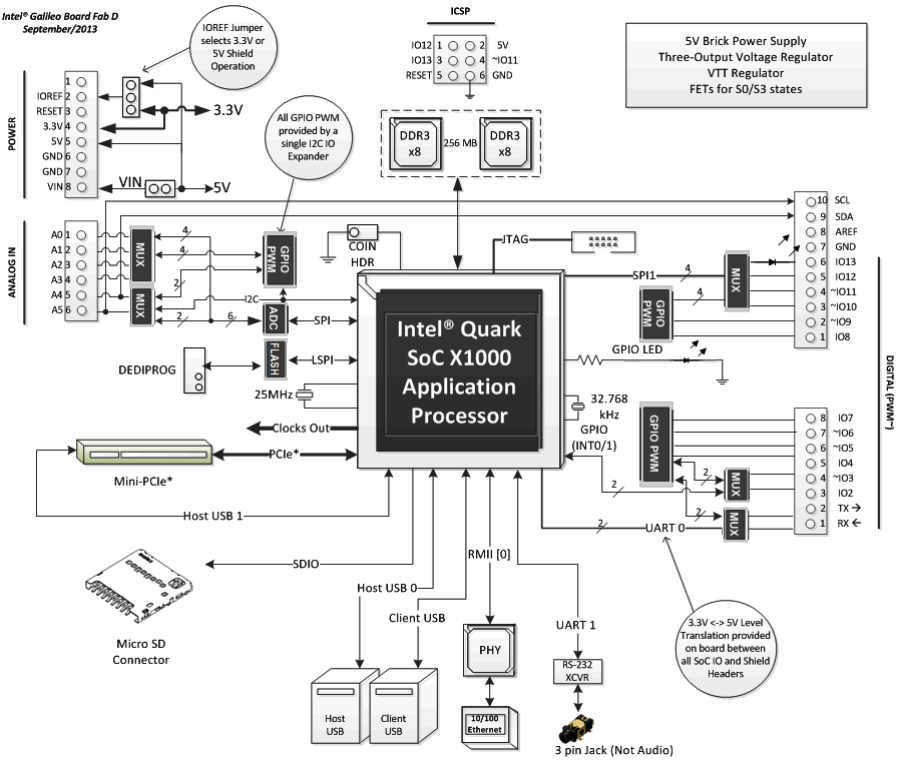
[picture p65: figure]

INTEL CORPORATION

### SYSTEM BLOCK DIAGRAM

D

D

AB

A

CB

C

## BGA393

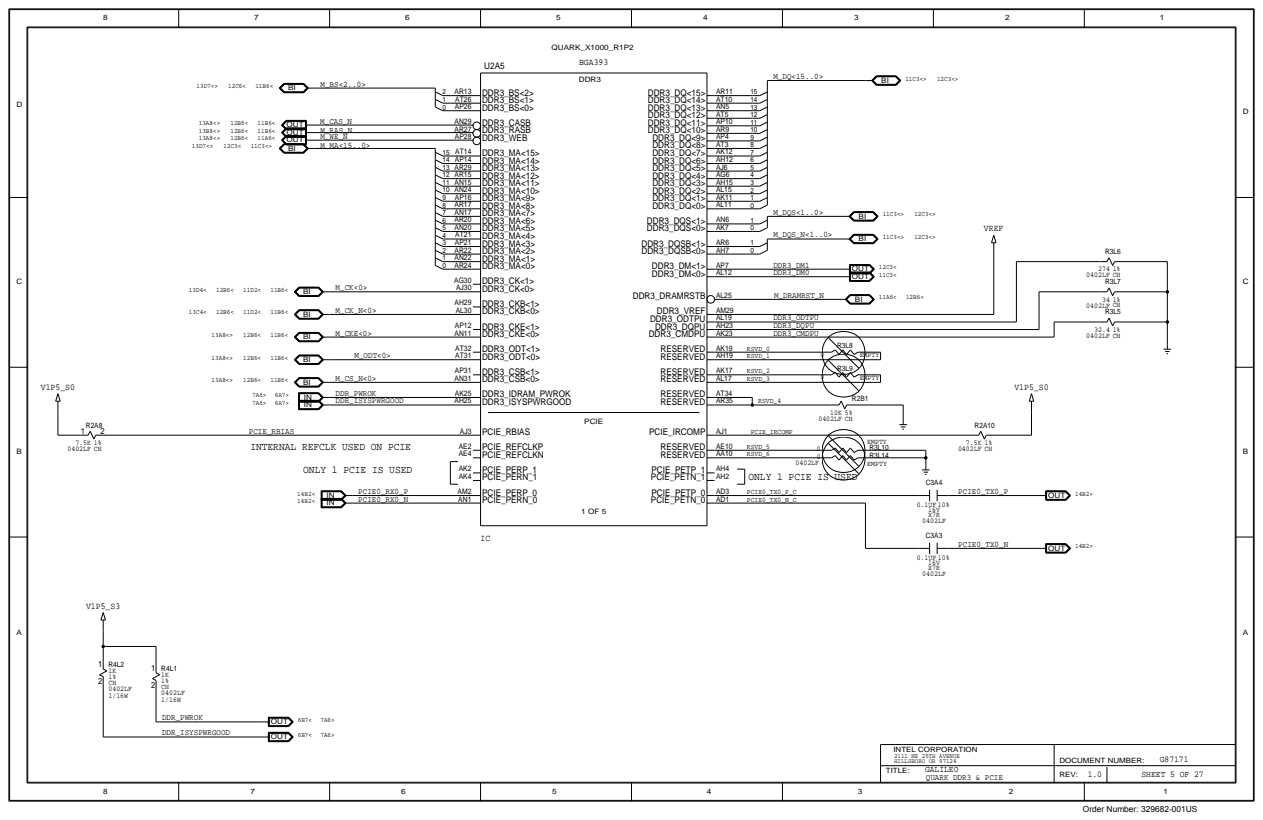
[picture p66: page 5]
ONLY 1 PCIE IS USED; PCIE_RBIAS; PCIE_IRCOMP; DDR_ISYSPWRGOOD; DDR_PWROK; DDR3_DM0; DDR3_DM1; PCIE0_TX0_N_C; PCIE0_TX0_P_C; PCIE0_RX0_N; PCIE0_RX0_P; M_ODT<0>; M_CKE<0>; RSVD_5; DDR3_ODTPU; RSVD_6; DDR3_CMDPU; DDR3_DQPU; RSVD_0; M_DRAMRST_N; RSVD_2; RSVD_1; RSVD_3; EMPTY; PCIE0_TX0_P; M_DQS_N<1..0>; M_DQS<1..0>; R3L14 EMPTY; M_RAS_N; M_CAS_N; PCIE0_TX0_N; DDR_PWROK DDR_ISYSPWRGOOD; RSVD_4; VREF; OUT; DDR3; PCIE; QUARK_X1000_R1P2; DDR3_ISYSPWRGOOD; DDR3_IDRAM_PWROK; DDR3_MA<1>; DDR3_DQ<15>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

INTERNAL REFCLK USED ON PCIE
ONLY 1 PCIE IS USED

INTEL CORPORATION HILLSBORO OR 97124 | G87171 ²¹¹¹ NE 25TH AVENUE
QUARK DDR3 & PCIE | 1.0 GALILEO | SHEET 5 OF 27

# ON-BOARD ADC

## BGA393

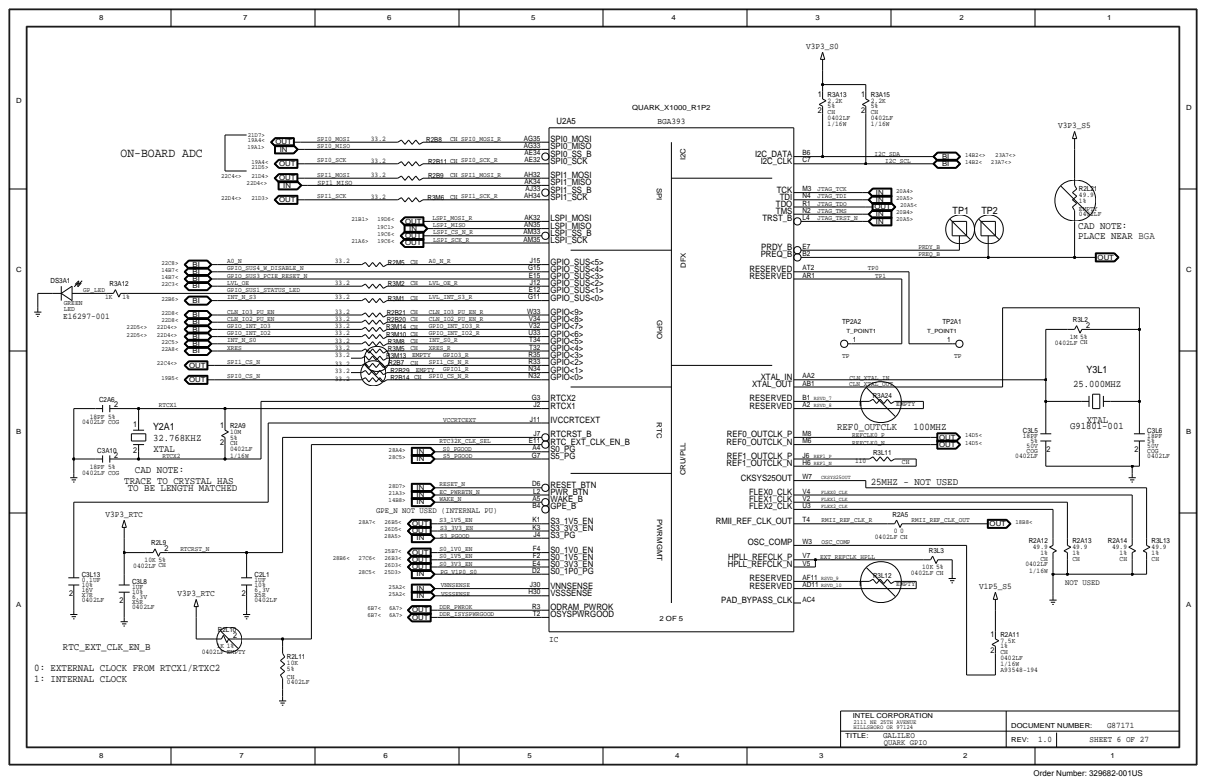
[picture p67: page 6]

10M | VCCRTCEXT J11

INTEL CORPORATION
QUARK GPIO

## NOT USED, LEAVE FLOATING

## BGA393

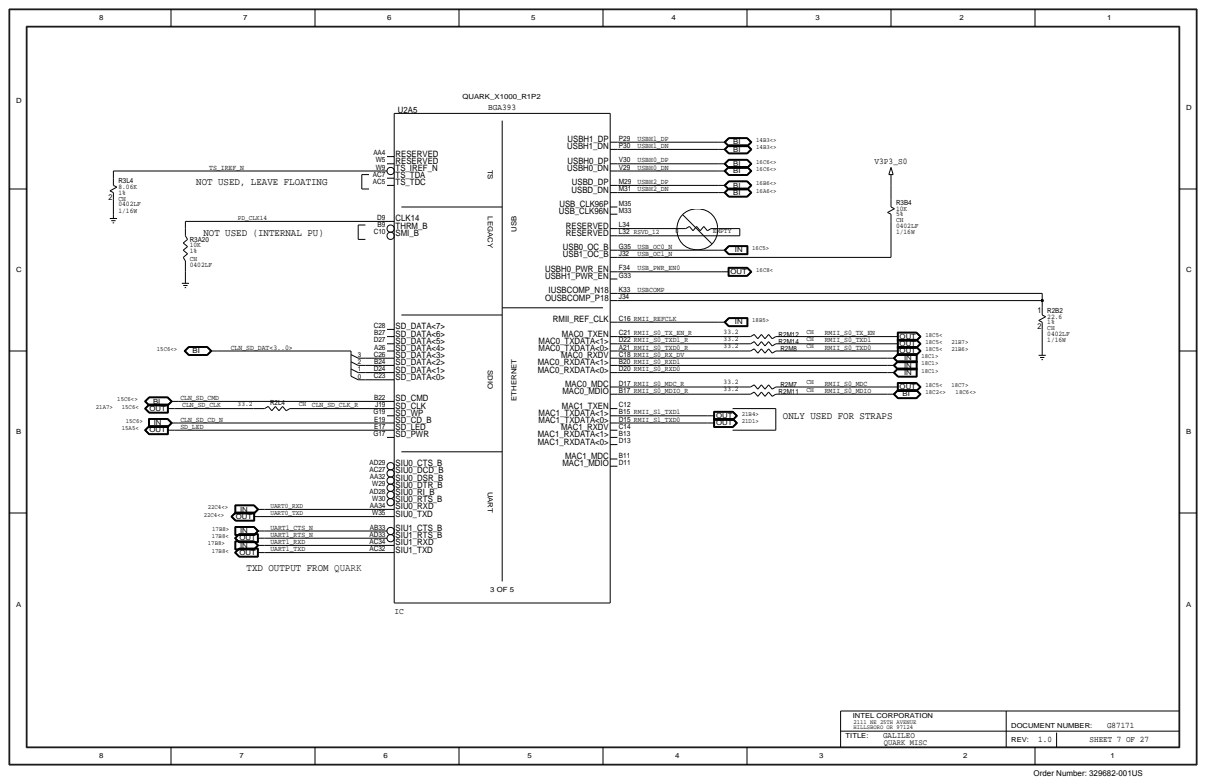
[picture p68: page 7]

INTEL CORPORATION
QUARK MISC

## BGA393 V3P3_S5

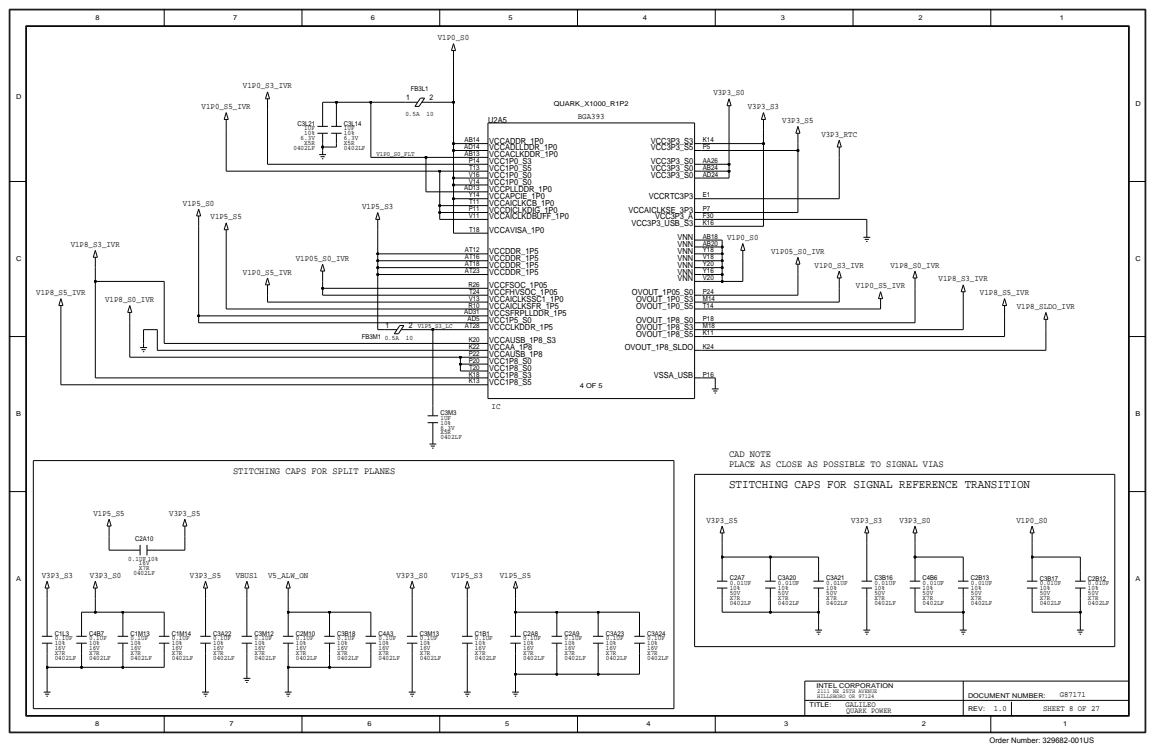
[picture p69: page 8]

AD14 | | P5
AB13 | | AA26
P14
T13 | | AB24

Y14
T11 | | P7
P11
V11 | | F30
T18 | | K16

AT16 | V18
AT18 | Y20
AT23 | Y16
R26 | V20
T24
V13 | | M14
R10 | | T14
AD31 | | P18
AD5

P22 | | P16 CAD NOTE
P20

PLACE AS CLOSE AS POSSIBLE TO SIGNAL VIAS
STITCHING CAPS FOR SIGNAL REFERENCE TRANSITION

STITCHING CAPS FOR SPLIT PLANES

INTEL CORPORATION
QUARK POWER

## BGA393

## V3P3_S3

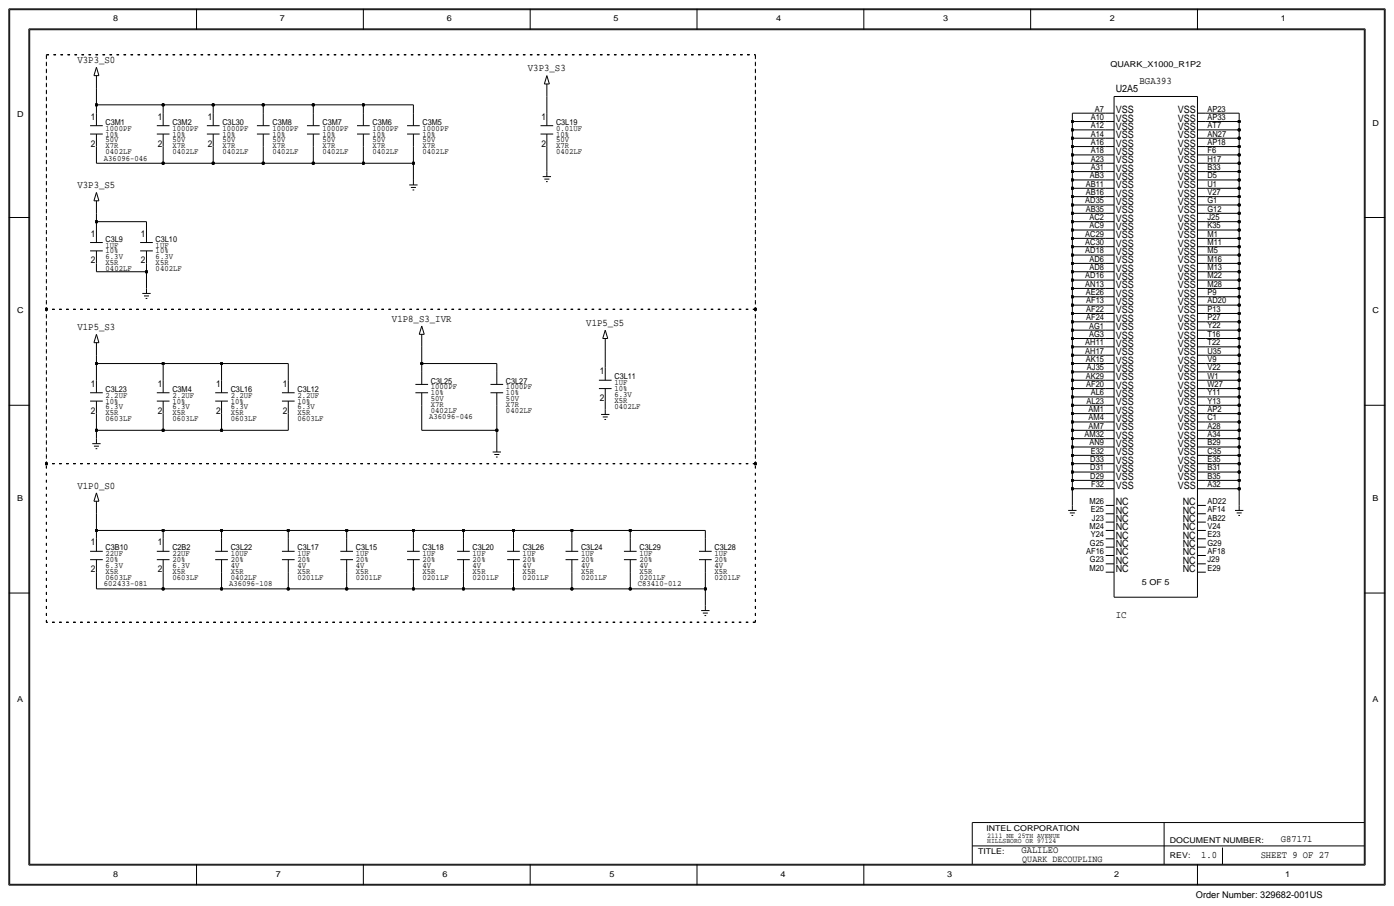
[picture p70: page 9]

A10 | AP33
A12 | AT7
A14 | AN27
A16 | AP18
A18 | F6
A23 | H17
AB3 | D5
AB11 | U1
AB16 | V27
AD35 | G1
AB35 | G12
AC2 | J25
AC29 | M1
AC30 | M11
AD18 | M5
AD6 | M16
AD8 | M13
AD16 | M22
AN13 | M28
AE26 | P9
AF13 | AD20
AF22 | P13
AF24 | P27
AG1 | Y22
AG3 | T16
AH11 | T22
AH17 | U35
AK15 | V9
AJ35 | V22
AK29 | W1
AF20 | W27
AL6 | Y11
AL23 | Y13
AM4 | C1
AM7 | A28
AM32 | A34
AN9 | B29
E32 | C35
D33 | E35
D29 | B35
F32 | A32

INTEL CORPORATION
QUARK DECOUPLING

## PLACE 0.1UF DECOUPLING AS CLOSE AS POSSIBLE TO DRAM POWER PINS

## CAD NOTE:

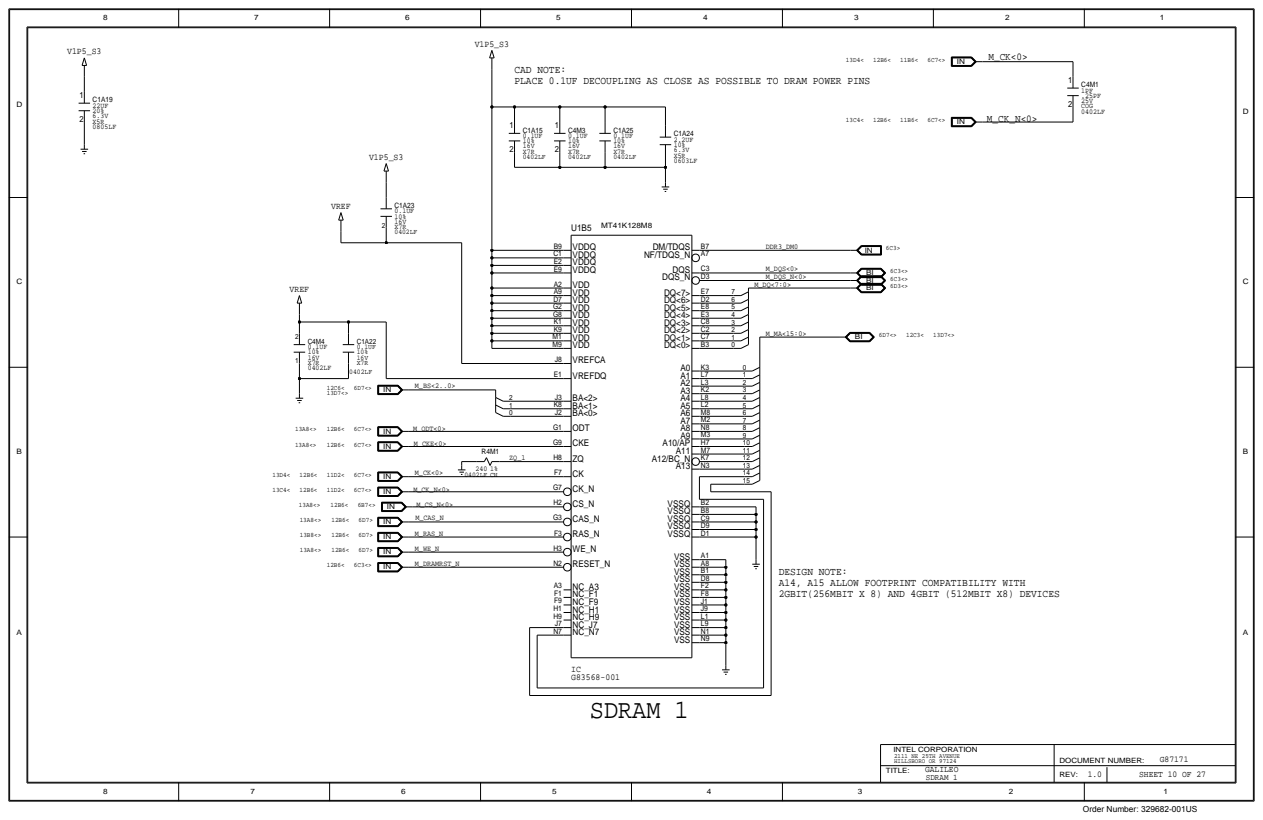
[picture p71: page 10]

DESIGN NOTE:
A14, A15 ALLOW FOOTPRINT COMPATIBILITY WITH
2GBIT(256MBIT X 8) AND 4GBIT (512MBIT X8) DEVICES

INTEL CORPORATION | G87171 ²¹¹¹ NE 25TH AVENUE
SDRAM 1

## PLACE 0.1UF DECOUPLING AS CLOSE AS POSSIBLE TO DRAM PINS

## CAD:

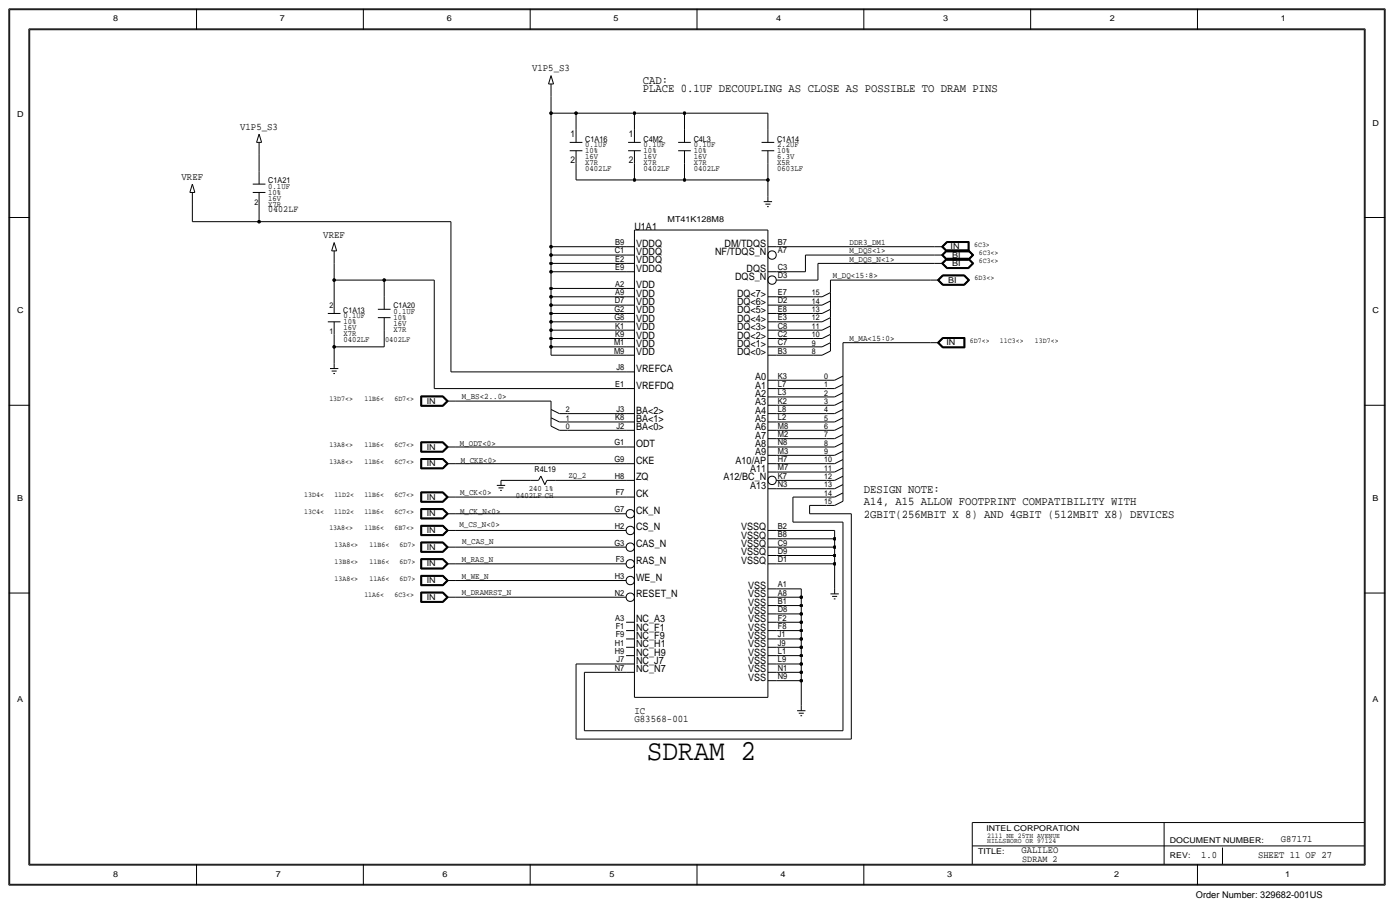
[picture p72: page 11]

INTEL CORPORATION HILLSBORO OR 97124 | G87171 ²¹¹¹ NE 25TH AVENUE
SDRAM 2 | 1.0 | SHEET 11 OF 27 GALILEO

## VTT

## VTT

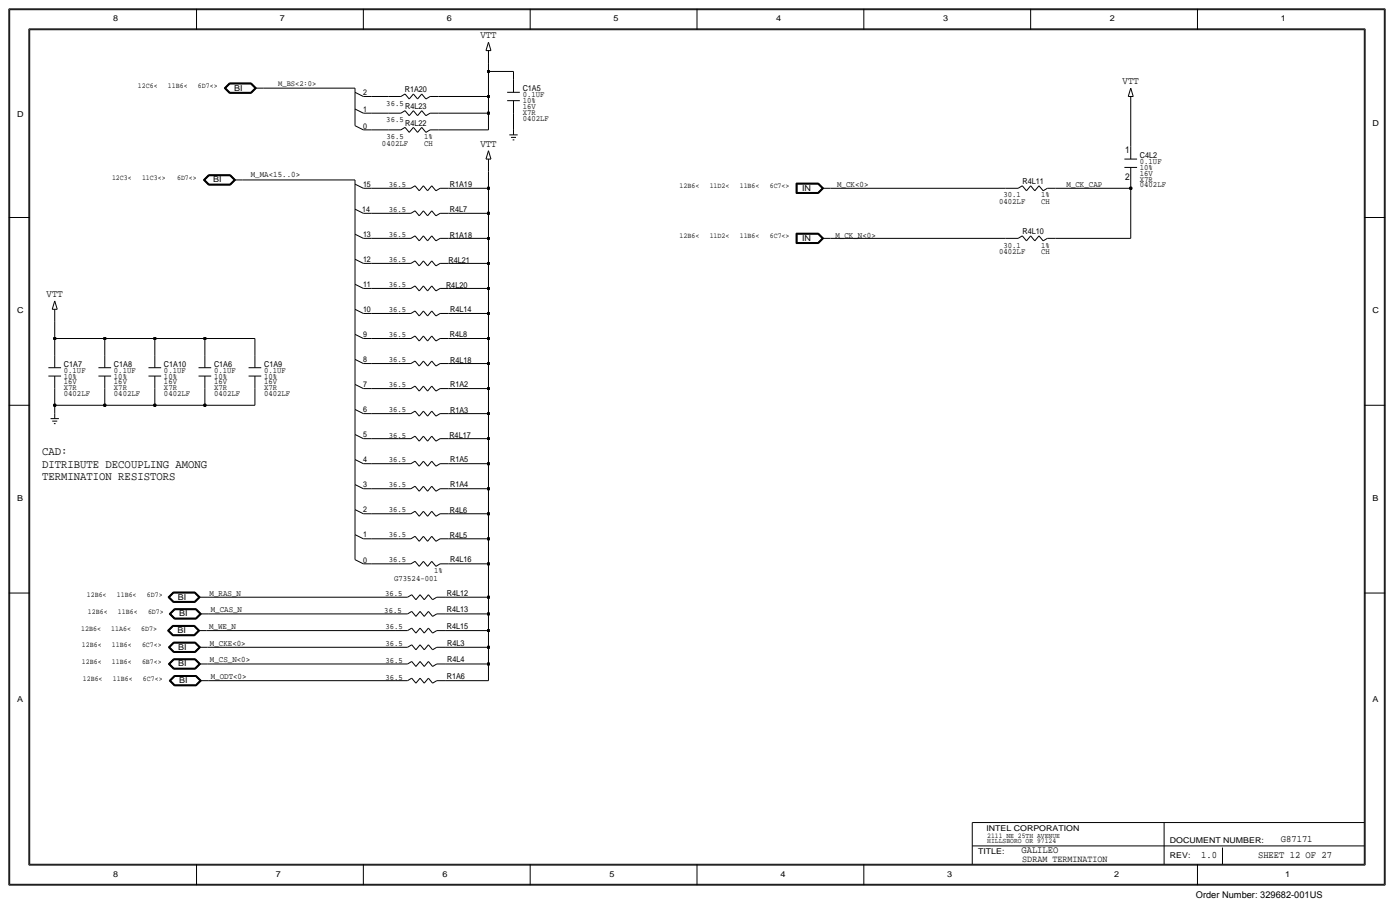
[picture p73: page 12]
M_CK_CAP; M_RAS_N M_CAS_N; M_CKE<0> M_CS_N<0> M_ODT<0>; VTT

CAD:
DITRIBUTE DECOUPLING AMONG
TERMINATION RESISTORS

INTEL CORPORATION
SDRAM TERMINATION

# PCIE SLOT 0

## CONN

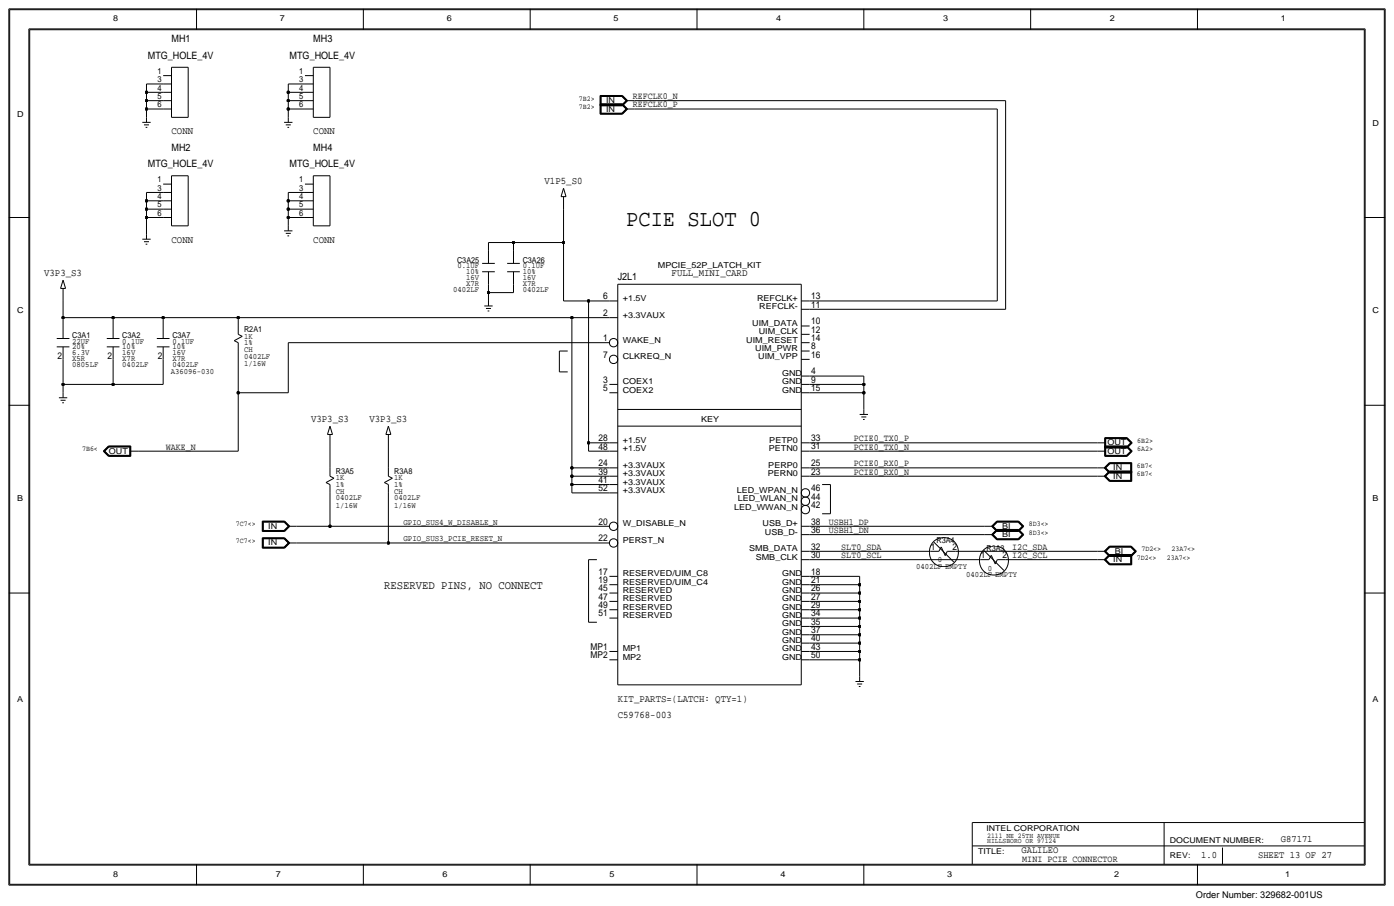
[picture p74: page 13]
0402LF EMPTY 0; EMPTY 0 0402LF; CONN; WAKE_N; REFCLK0_N; PCIE0_TX0_P; PCIE0_RX0_P; SLT0_SCL; REFCLK0_P; GPIO_SUS3_PCIE_RESET_N; GPIO_SUS4_W_DISABLE_N; I2C_SCL; KIT_PARTS=(LATCH: QTY=1); FULL_MINI_CARD; MTG_HOLE_4V; OUT; OUT OUT; REFCLK+ REFCLK-; PERN0; PERP0; PETP0 PETN0; LED_WWAN_N; LED_WLAN_N; LED_WPAN_N; USB_D+ USB_D-; RESERVED/UIM_C4; RESERVED/UIM_C8; +3.3VAUX; COEX2; CLKREQ_N; W_DISABLE_N; RESERVED; UIM_CLK; UIM_DATA; UIM_RESET UIM_PWR UIM_VPP; SMB_DATA SMB_CLK; GND GND; GND; PERST_N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

48 | 31 PCIE0_TX0_N
39 | 23 PCIE0_RX0_N
41 | USBH1_DP BI 8D3<> 36 USBH1_DN 8D3<> BI 32 SLT0_SDA I2C_SDA 18

RESERVED PINS, NO CONNECT

INTEL CORPORATION
MINI PCIE CONNECTOR

## V3P3_S0

IC

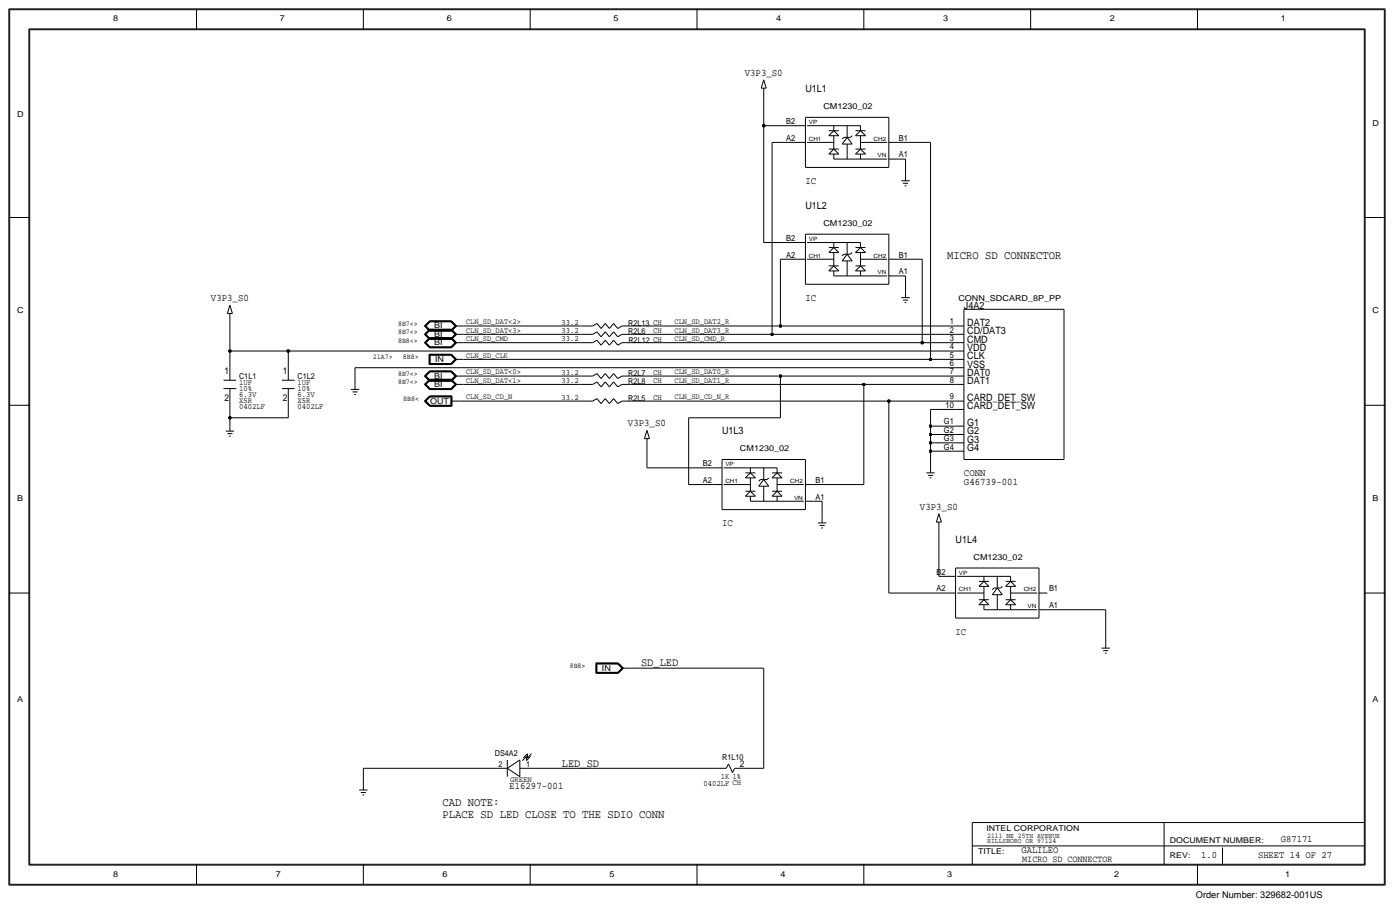
[picture p75: page 14]
CLN_SD_CD_N_R; CLN_SD_CMD CLN_SD_CLK; CLN_SD_CMD_R; CLN_SD_DAT3_R; CLN_SD_DAT2_R; CLN_SD_DAT0_R; SD_LED; CLN_SD_CD_N; CLN_SD_DAT<0>; LED_SD; CLN_SD_DAT<3>; CLN_SD_DAT<2>; CLN_SD_DAT<1>; CLN_SD_DAT1_R; CONN G46739-001; GREEN E16297-001; OUT; CONN_SDCARD_8P_PP; CARD_DET_SW G1; DAT1; CMD VDD; DAT0; VSS; CLK; CD/DAT3; DAT2

MICRO SD CONNECTOR

CAD NOTE:
PLACE SD LED CLOSE TO THE SDIO CONN

INTEL CORPORATION HILLSBORO OR 97124 | G87171
MICRO SD CONNECTOR | 1.0 | SHEET 14 OF 27 GALILEO

## CAD NOTE:

## NOTE:

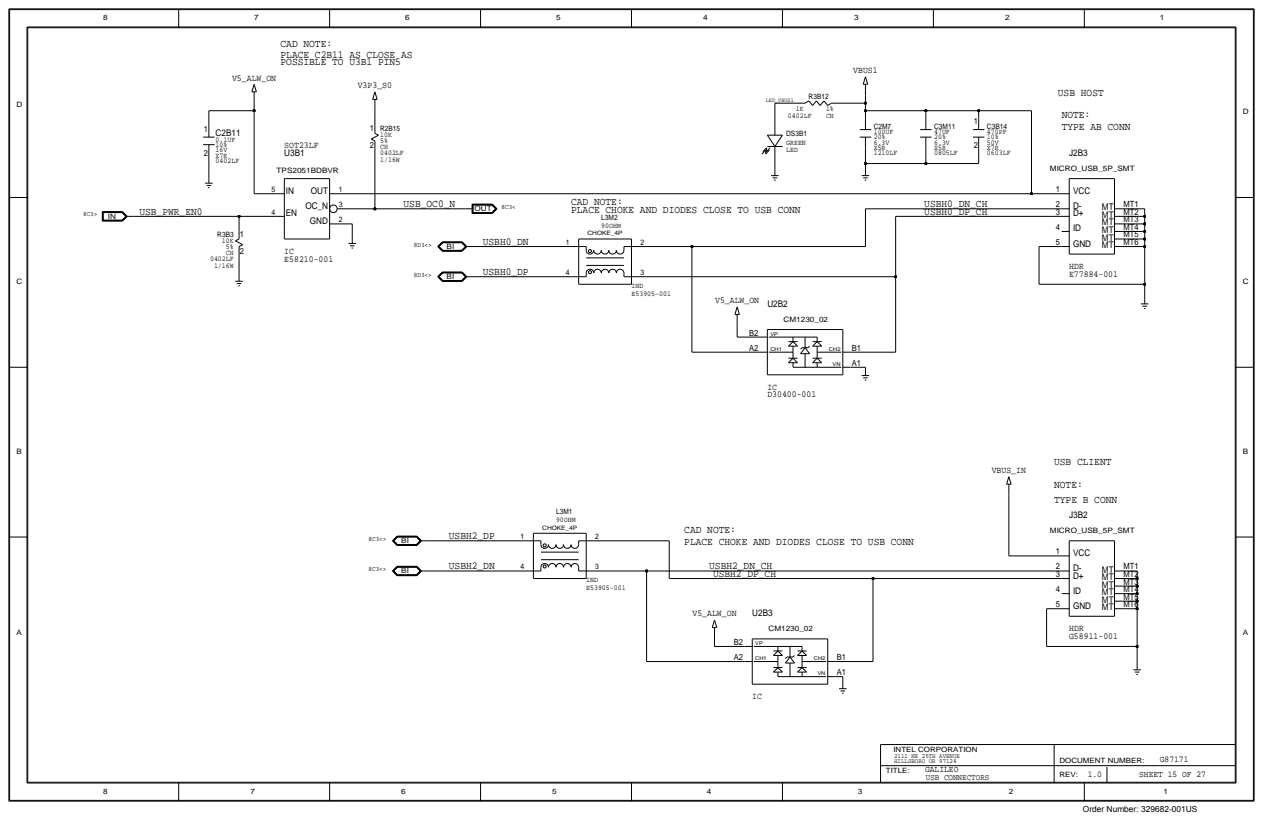
[picture p76: page 15]
USB CLIENT; TYPE B CONN; NOTE:; VBUS1; USBH2_DP; USBH2_DN; USBH0_DP; USB_OC0_N; USBH0_DN; USB_PWR_EN0; LED_VBUS1; USBH0_DN_CH; IND; 90OHM; LED; GREEN; VBUS_IN; HDR; V5_ALW_ON; SOT23LF; CHOKE_4P; MICRO_USB_5P_SMT; GND; VCC; TPS2051BDBVR; OC_N GND; OUT

CAD NOTE:
PLACE C2B11 AS CLOSE AS
POSSIBLE TO U3B1 PIN5

USB HOST
TYPE AB CONN

PLACE CHOKE AND DIODES CLOSE TO USB CONN
90OHM
CHOKE_4P

USBH0_DP_CH 3 | MT2

USBH2_DN_CH
USBH2_DP_CH

INTEL CORPORATION
USB CONNECTORS

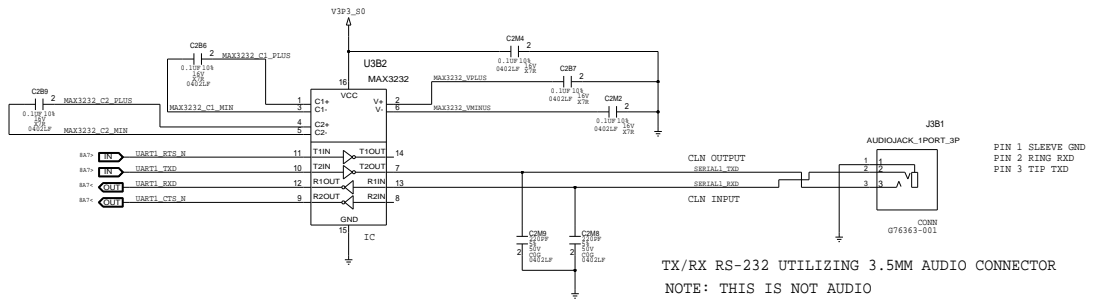
[picture p77: page 16]
CLN INPUT; CLN OUTPUT; MAX3232_VMINUS; MAX3232_VPLUS; UART1_RTS_N UART1_TXD; MAX3232_C1_PLUS; MAX3232_C1_MIN; MAX3232_C2_PLUS; UART1_RXD UART1_CTS_N; MAX3232_C2_MIN; SERIAL1_TXD SERIAL1_RXD; CONN; AUDIOJACK_1PORT_3P; R1OUT; T2OUT; T1OUT; VCC; GND; MAX3232; R2OUT OUT; OUT

PIN 1 SLEEVE GND
PIN 2 RING RXD
PIN 3 TIP TXD

TX/RX RS-232 UTILIZING 3.5MM AUDIO CONNECTOR
NOTE: THIS IS NOT AUDIO

INTEL CORPORATION
UART 1

## V3P3_S0 V3P3_S0_A

## V3P3_S0_A

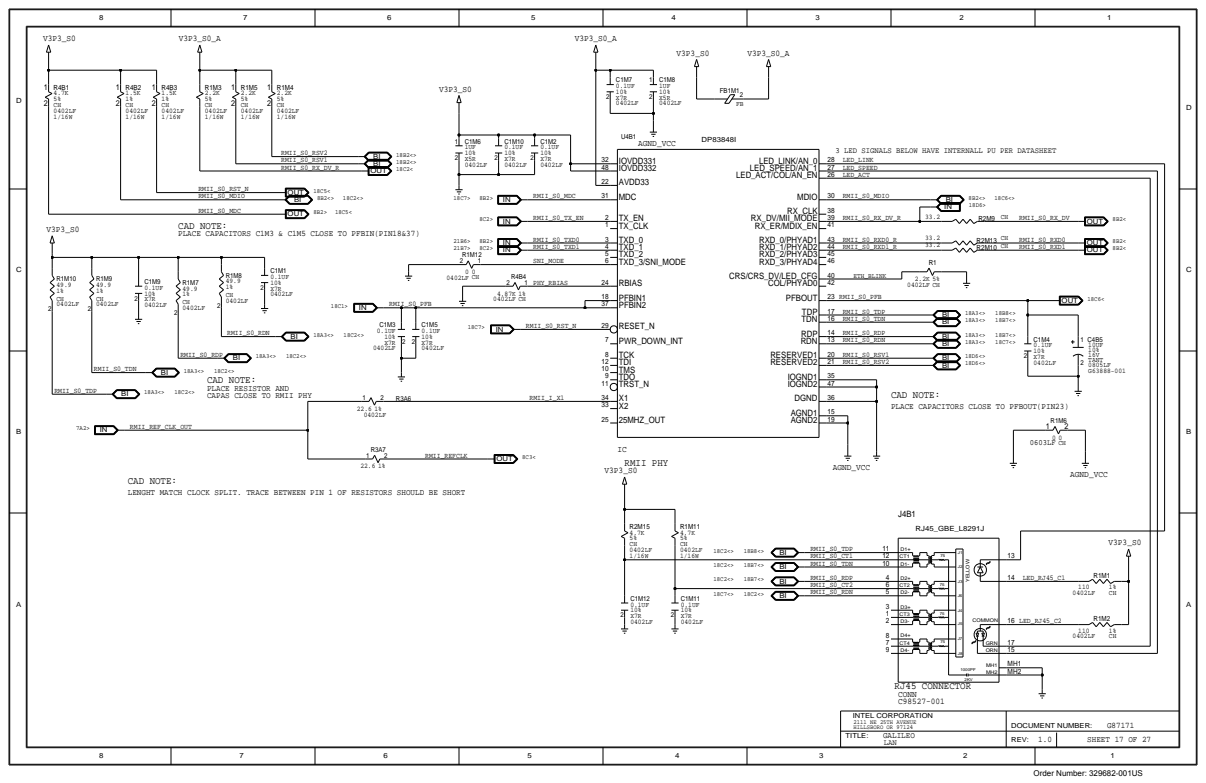
[picture p78: page 17]

CAD NOTE:
LENGHT MATCH CLOCK SPLIT. TRACE BETWEEN PIN 1 OF RESISTORS SHOULD BE SHORT

INTEL CORPORATION
LAN

## BAT54C DIO

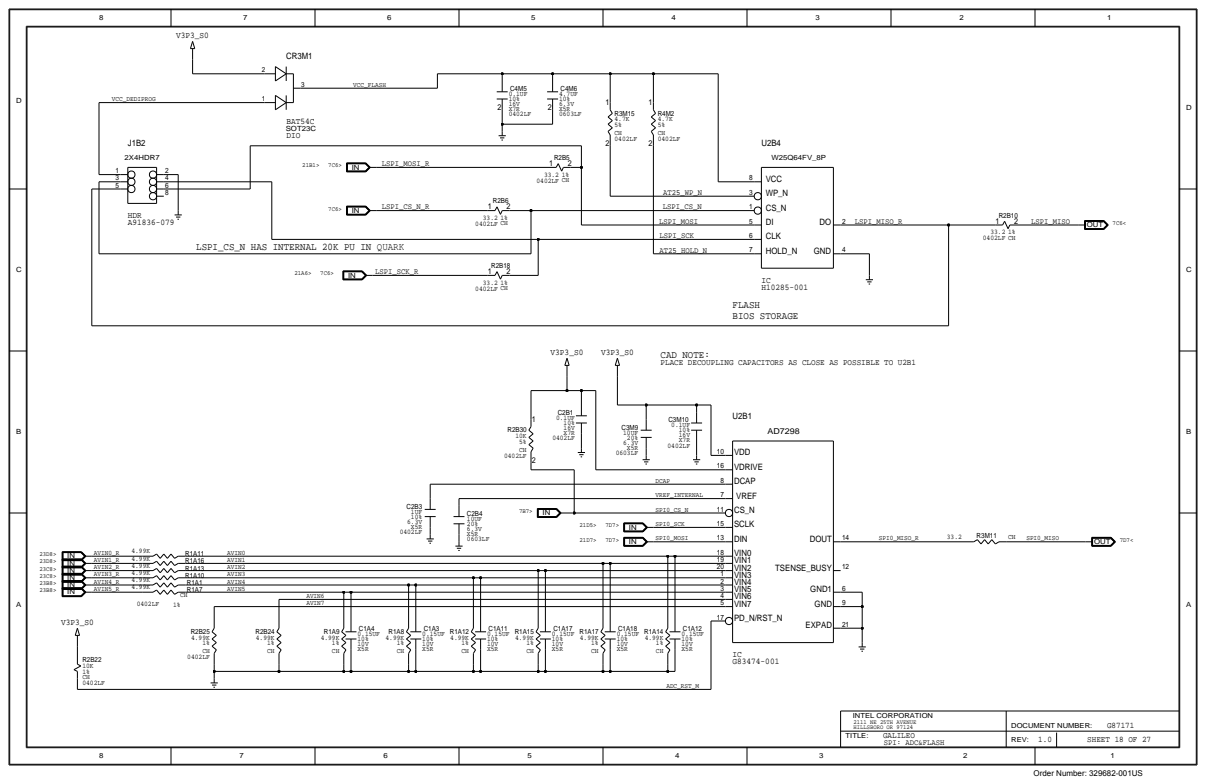
[picture p79: page 18]
FLASH BIOS STORAGE; AVIN1; VCC_DEDIPROG; AVIN5; AVIN0 AVIN2 AVIN3; AVIN0_R; AVIN5_R; AVIN4_R; AVIN3_R; AVIN2_R; AVIN1_R; SPI0_SCK; SPI0_MISO_R; SPI0_MISO; AVIN4; LSPI_MISO; LSPI_SCK_R; LSPI_MOSI_R; LSPI_CS_N_R; AT25_HOLD_N; LSPI_SCK; AT25_WP_N LSPI_CS_N; SPI0_MOSI; DCAP VREF_INTERNAL SPI0_CS_N; ADC_RST_M; AVIN7; AVIN6; LSPI_MOSI; VCC_FLASH; LSPI_MISO_R; HDR; SOT23C; OUT; 2X4HDR7; VDRIVE; PD_N/RST_N; SCLK; DIN; DOUT; TSENSE_BUSY; VDD; DCAP; GND1; VIN7; VIN6; VIN5; VIN4; VIN3; VIN2; VIN1; VIN0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

LSPI_CS_N HAS INTERNAL 20K PU IN QUARK

CAD NOTE:
PLACE DECOUPLING CAPACITORS AS CLOSE AS POSSIBLE TO U2B1

INTEL CORPORATION
SPI: ADC&FLASH | 1.0 | SHEET 18 OF 27

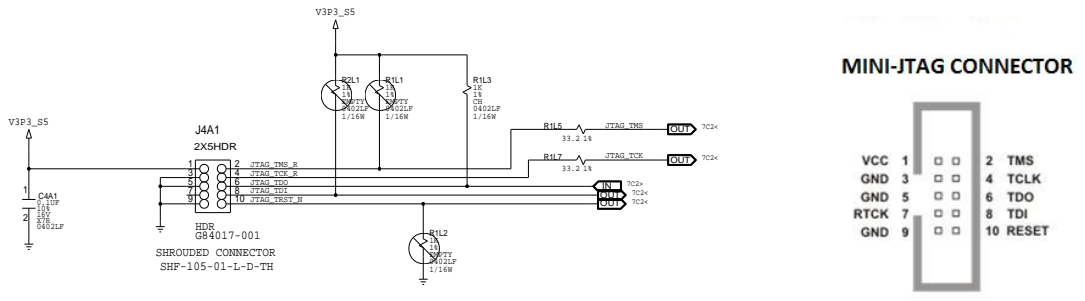
[picture p80: page 19]
SHROUDED CONNECTOR SHF-105-01-L-D-TH; 1/16W 0402LF EMPTY; EMPTY; JTAG_TCK; JTAG_TDI; JTAG_TMS_R; JTAG_TMS; JTAG_TRST_N; JTAG_TDO; JTAG_TCK_R; HDR G84017-001; R1L2 EMPTY; 2X5HDR; OUT

INTEL CORPORATION
I2CPROM & JTAG CONN

## V3P3_S0

## V3P3_S0

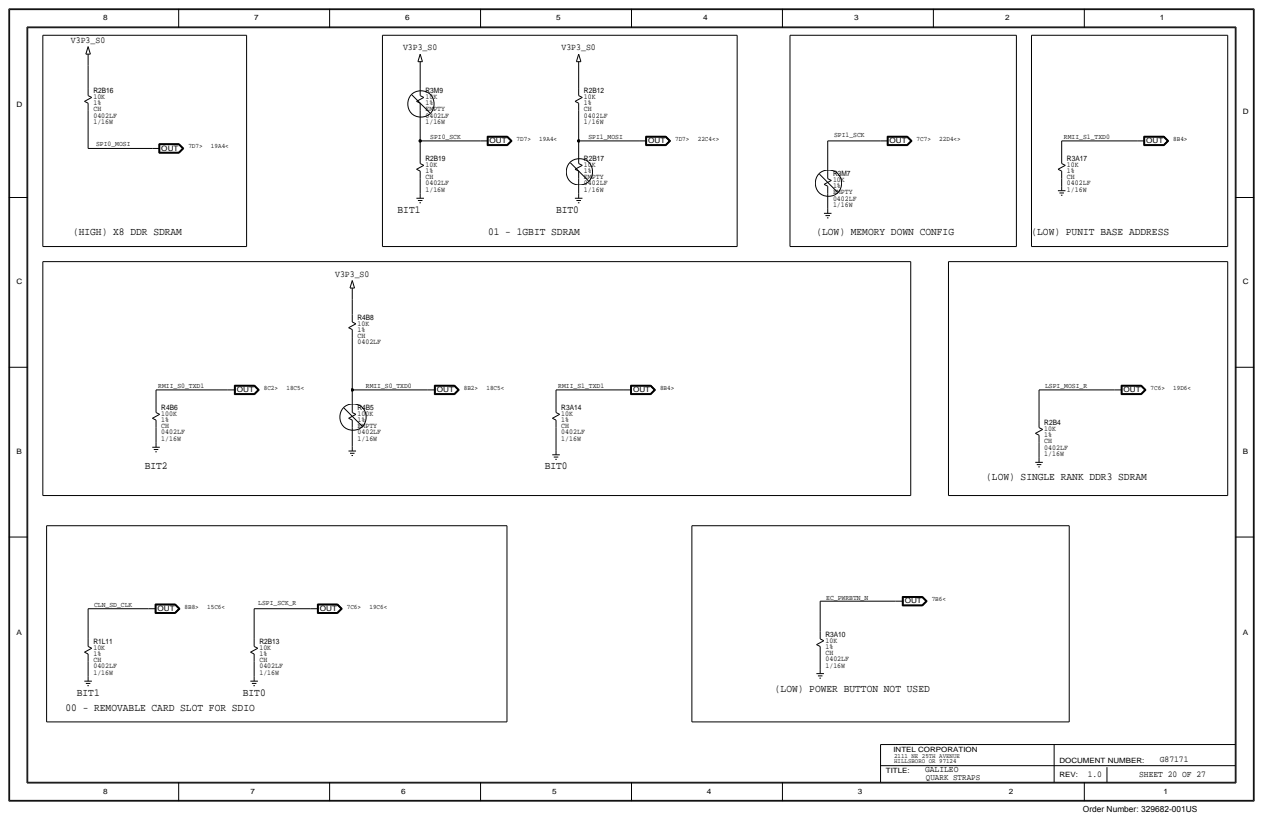
[picture p81: page 20]
(LOW) MEMORY DOWN CONFIG; (LOW) PUNIT BASE ADDRESS; BIT0; BIT1; (LOW) POWER BUTTON NOT USED; 00 - REMOVABLE CARD SLOT FOR SDIO; BIT2; (HIGH) X8 DDR SDRAM; 01 - 1GBIT SDRAM; RMII_S0_TXD0; RMII_S1_TXD1; SPI0_MOSI; EC_PWRBTN_N; SPI0_SCK; SPI1_MOSI; SPI1_SCK; CLN_SD_CLK; LSPI_SCK_R; LSPI_MOSI_R; RMII_S1_TXD0; R3M9 EMPTY 0402LF 1/16W; EMPTY; RMII_S0_TXD1; 10K EMPTY; 100K 1% EMPTY; OUT

(LOW) SINGLE RANK DDR3 SDRAM

INTEL CORPORATION
QUARK STRAPS

G63512-001

## V3P3_S3

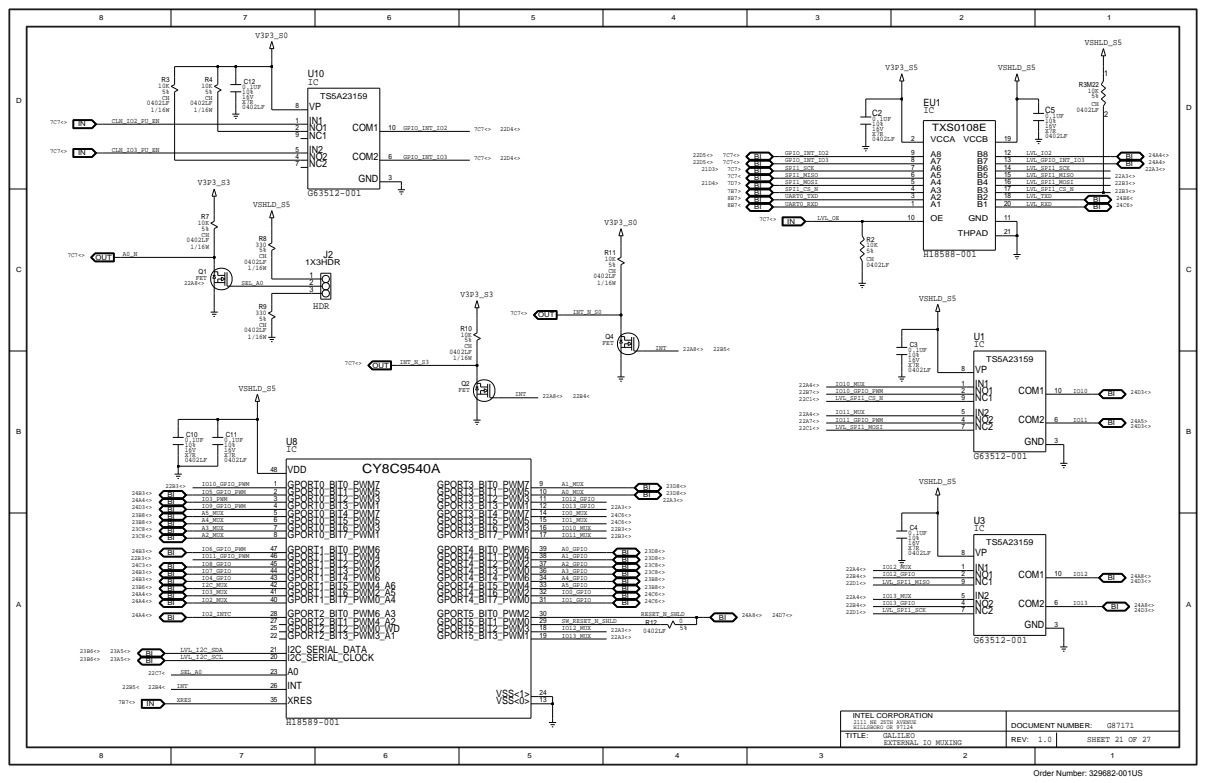
[picture p82: page 21]

INTEL CORPORATION
EXTERNAL IO MUXING

## THLF

IC

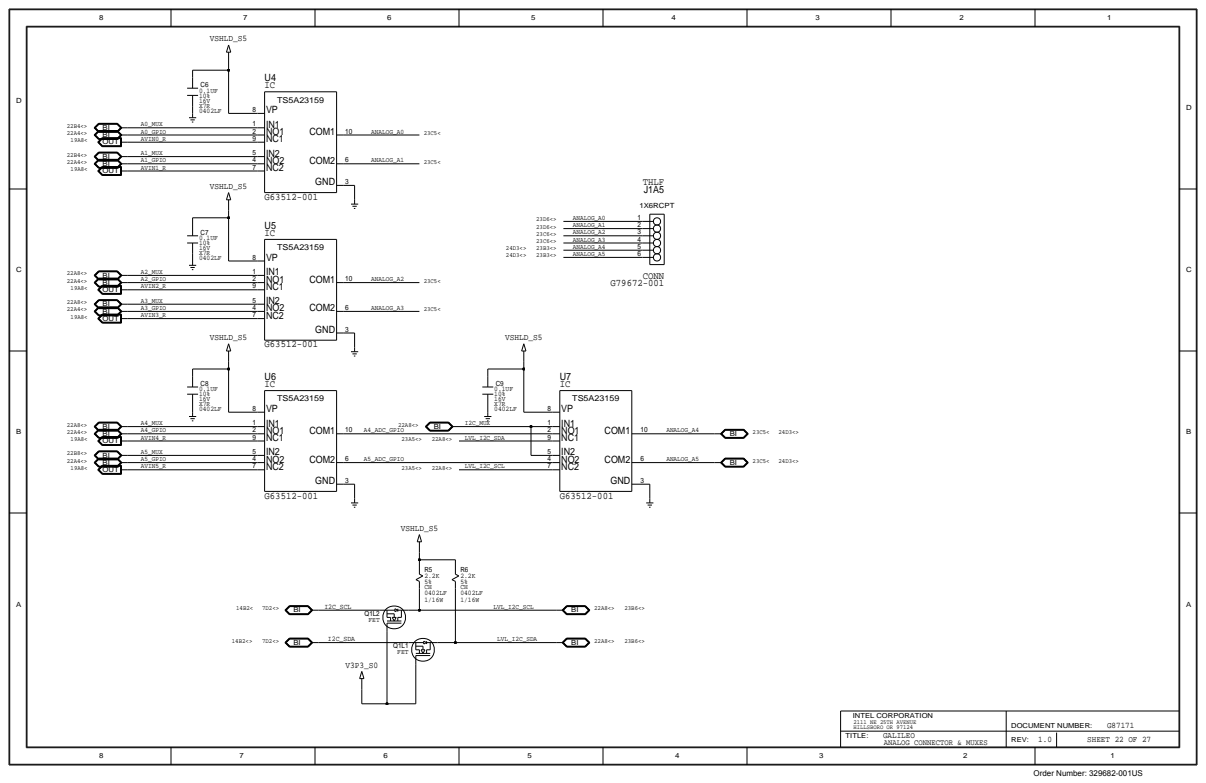
[picture p83: page 22]

INTEL CORPORATION
ANALOG CONNECTOR & MUXES

## DIGITAL 8

## DIGITAL 10

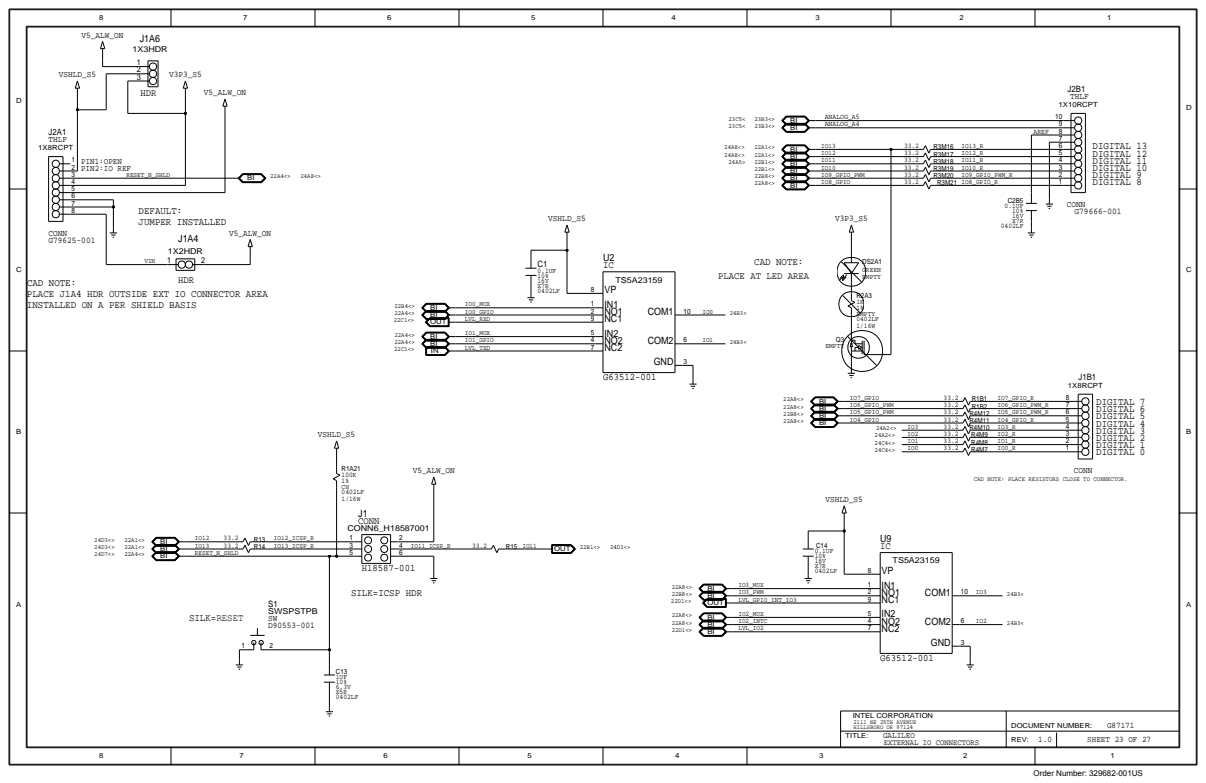
[picture p84: page 23]

CAD NOTE:
PLACE AT LED AREA

PLACE J1A4 HDR OUTSIDE EXT IO CONNECTOR AREA
INSTALLED ON A PER SHIELD BASIS

CAD NOTE: PLACE RESISTORS CLOSE TO CONNECTOR.

INTEL CORPORATION
EXTERNAL IO CONNECTORS

## MAX LOAD: 2.0A

## VIH_EN = 2.18V

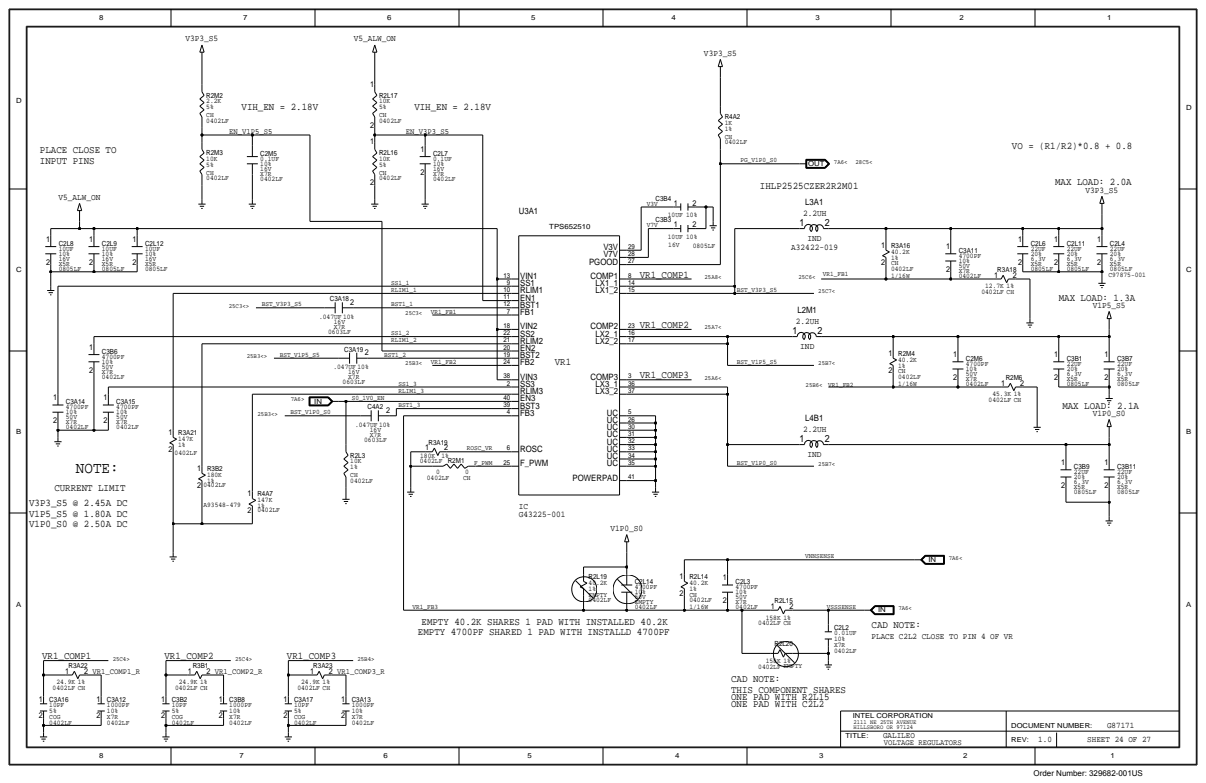
[picture p85: page 24]
CURRENT LIMIT; NOTE:; MAX LOAD: 2.1A; IHLP2525CZER2R2M01; MAX LOAD: 1.3A; VIH_EN = 2.18V; BST_V3P3_S5; BST_V1P5_S5; RLIM1_3; ROSC_VR; BST1_3; BST_V1P0_S0; BST1_2; VR1_COMP1_R; VR1_COMP2_R; VR1_COMP2; VR1_COMP1; VR1_COMP3; VR1_COMP3_R; F_PWM; VNNSENSE; 4700PF EMPTY; R2L19 40.2K EMPTY 0402LF; IND; V5_ALW_ON; 5% COG; COG 0402LF; COG; OUT; TPS652510; POWERPAD; EN3 BST3; VIN3; V3V V7V PGOOD; COMP2; SS2 RLIM2 EN2 BST2; VIN2; VIN1; BST1; RLIM1; COMP1; ROSC; COMP3; SS3 RLIM3

PLACE CLOSE TO
INPUT PINS

RLIM1_1 | 10

2 C3A18 .047UF 10% 16V 0603LF X7R | BST1_1 | 11

4700PF | RLIM1_2 | 21

EMPTY 40.2K SHARES 1 PAD WITH INSTALLED 40.2K
EMPTY 4700PF SHARED 1 PAD WITH INSTALLD 4700PF

VSSSENSE
CAD NOTE:
PLACE C2L2 CLOSE TO PIN 4 OF VR

EMPTY
THIS COMPONENT SHARES
ONE PAD WITH R2L15
ONE PAD WITH C2L2

INTEL CORPORATION
VOLTAGE REGULATORS

# V3P3_S5 IS GENERATED W ON-BRD REGULATOR

IC

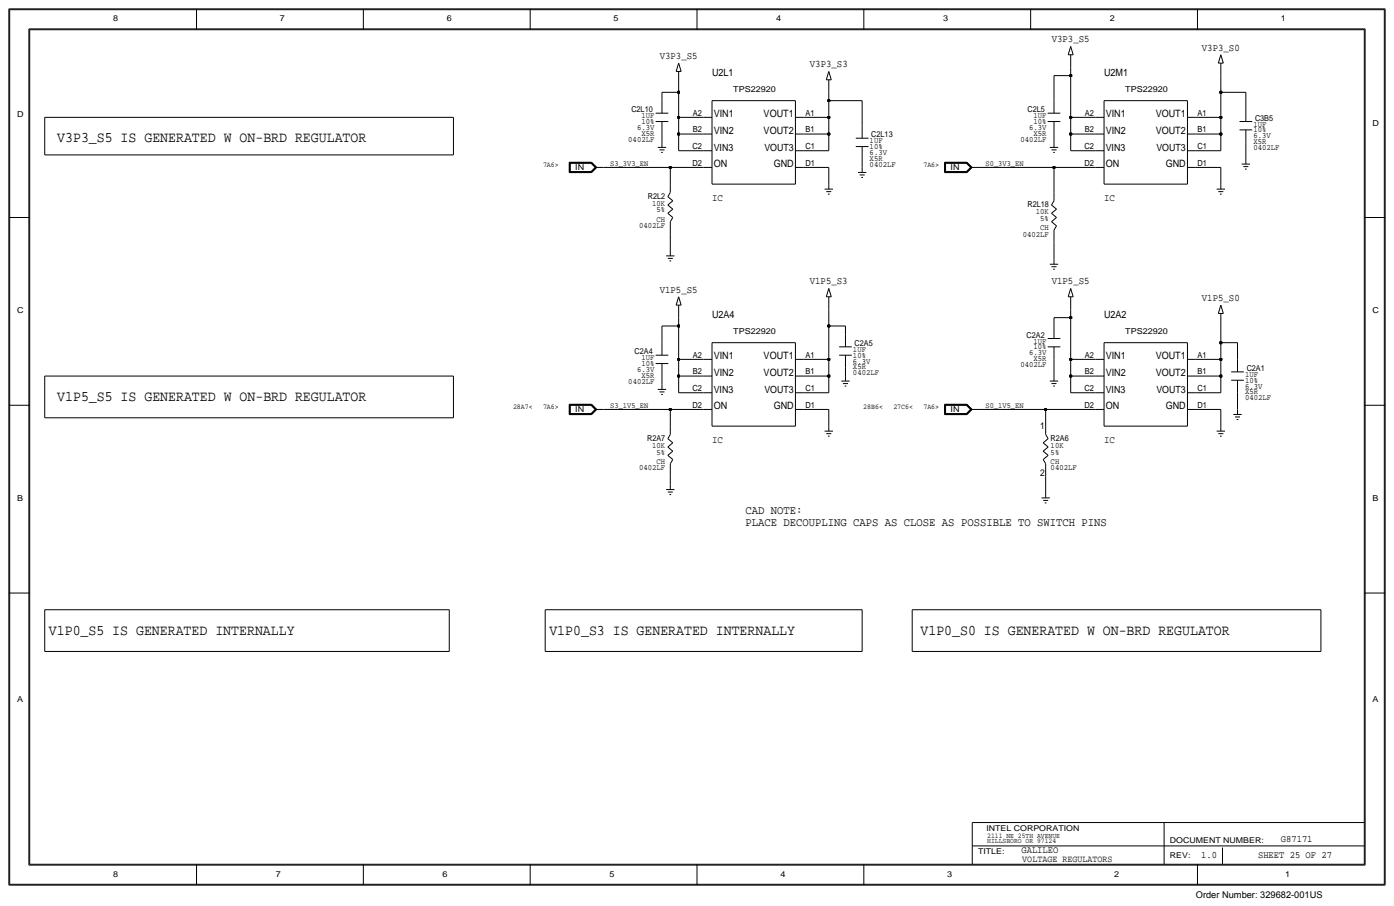
[picture p86: page 25]
V1P0_S5 IS GENERATED INTERNALLY; V1P0_S3 IS GENERATED INTERNALLY; V1P0_S0 IS GENERATED W ON-BRD REGULATOR; R2L18 10K 5% 0402LFCH; TPS22920; VIN3; VOUT3; VIN2; GND; VOUT1 VOUT2; VIN1

V1P5_S5 IS GENERATED W ON-BRD REGULATOR

CAD NOTE:
PLACE DECOUPLING CAPS AS CLOSE AS POSSIBLE TO SWITCH PINS

INTEL CORPORATION
VOLTAGE REGULATORS

## REFOUT IS INDEPENDENT OF ENABLE PIN

## VREF

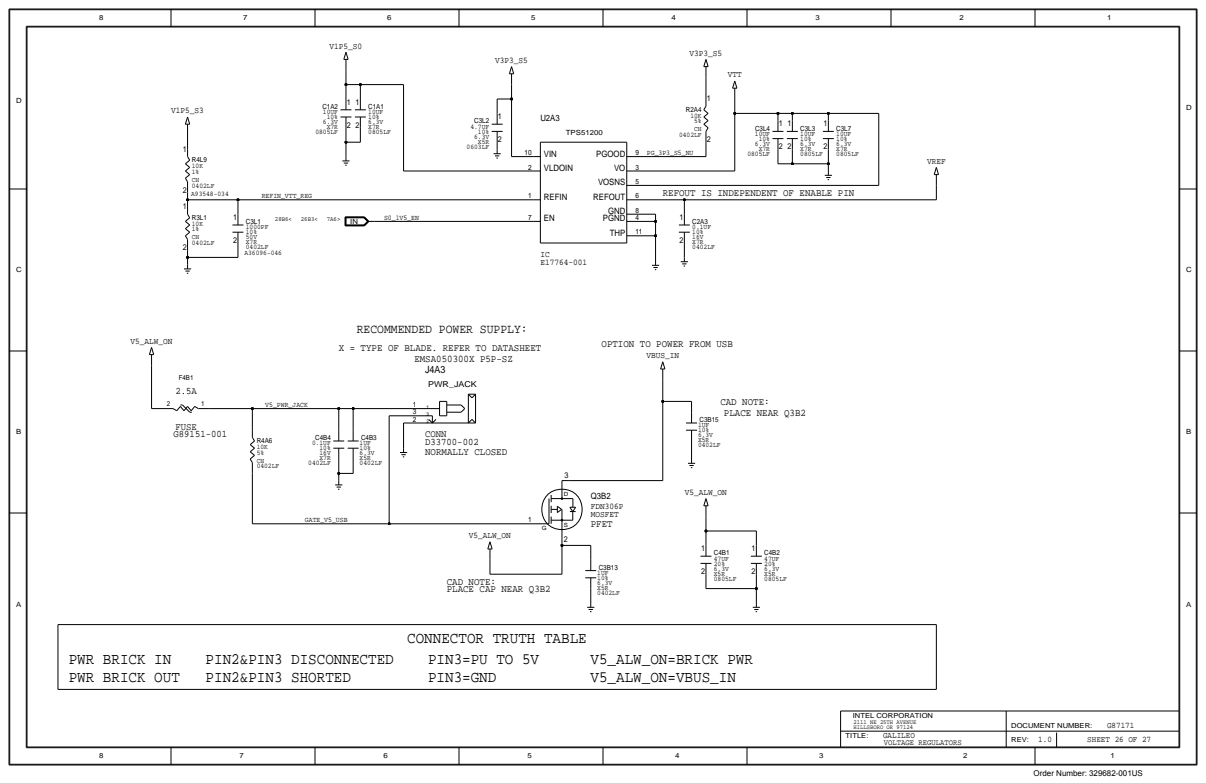
[picture p87: page 26]
PWR BRICK OUT PIN2&PIN3 SHORTED; PIN3=GND; V5_ALW_ON=VBUS_IN; PWR BRICK IN; PIN2&PIN3 DISCONNECTED; PIN3=PU TO 5V; V5_ALW_ON=BRICK PWR; EMSA050300X P5P-SZ; PLACE NEAR Q3B2; NORMALLY CLOSED; PFET; CAD NOTE:; V5_PWR_JACK; REFIN_VTT_REG; GATE_V5_USB; V5_ALW_ON; MOSFET; FDN306P; FUSE; CONN; VTT; PWR_JACK; TPS51200; VIN VLDOIN; REFIN; THP; PGND; GND; REFOUT; VOSNS; PGOOD

RECOMMENDED POWER SUPPLY:
X = TYPE OF BLADE. REFER TO DATASHEET

OPTION TO POWER FROM USB
VBUS_IN

CAD NOTE:
PLACE CAP NEAR Q3B2
CONNECTOR TRUTH TABLE

INTEL CORPORATION
VOLTAGE REGULATORS

SS:

# REBOOT

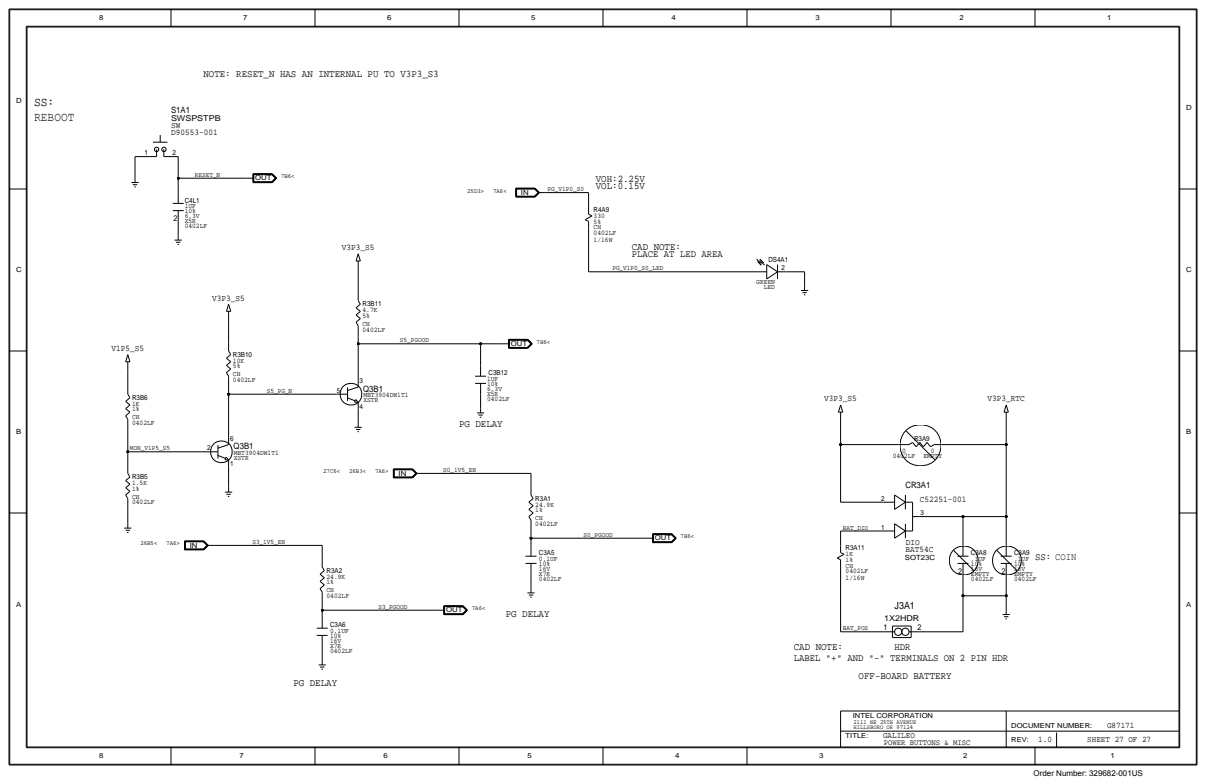
[picture p88: page 27]
PG DELAY; SS: COIN; OFF-BOARD BATTERY; CAD NOTE:; PLACE AT LED AREA; VOL:0.15V; VOH:2.25V; RESET_N; PG_V1P0_S0_LED; S5_PGOOD; MON_V1P5_S5; S0_PGOOD; BAT_DIO; S3_PGOOD; .1UF 10% 16V EMPTY 0402LF; .1UF 10% EMPTY 0402LF; V3P3_RTC; DIO BAT54C; EMPTY 0; MBT3904DW1T1 XSTR; XSTR; MBT3904DW1T1; HDR; LED GREEN; SOT23C; OUT; 1X2HDR; SWSPSTPB

NOTE: RESET_N HAS AN INTERNAL PU TO V3P3_S3

BAT_POS
CAD NOTE:
LABEL "+" AND "-" TERMINALS ON 2 PIN HDR

INTEL CORPORATION
POWER BUTTONS & MISC
