GitForEng/syncbox/Artifacts/Reports/SyncBox/SyncBox Activity Diagram.pdf

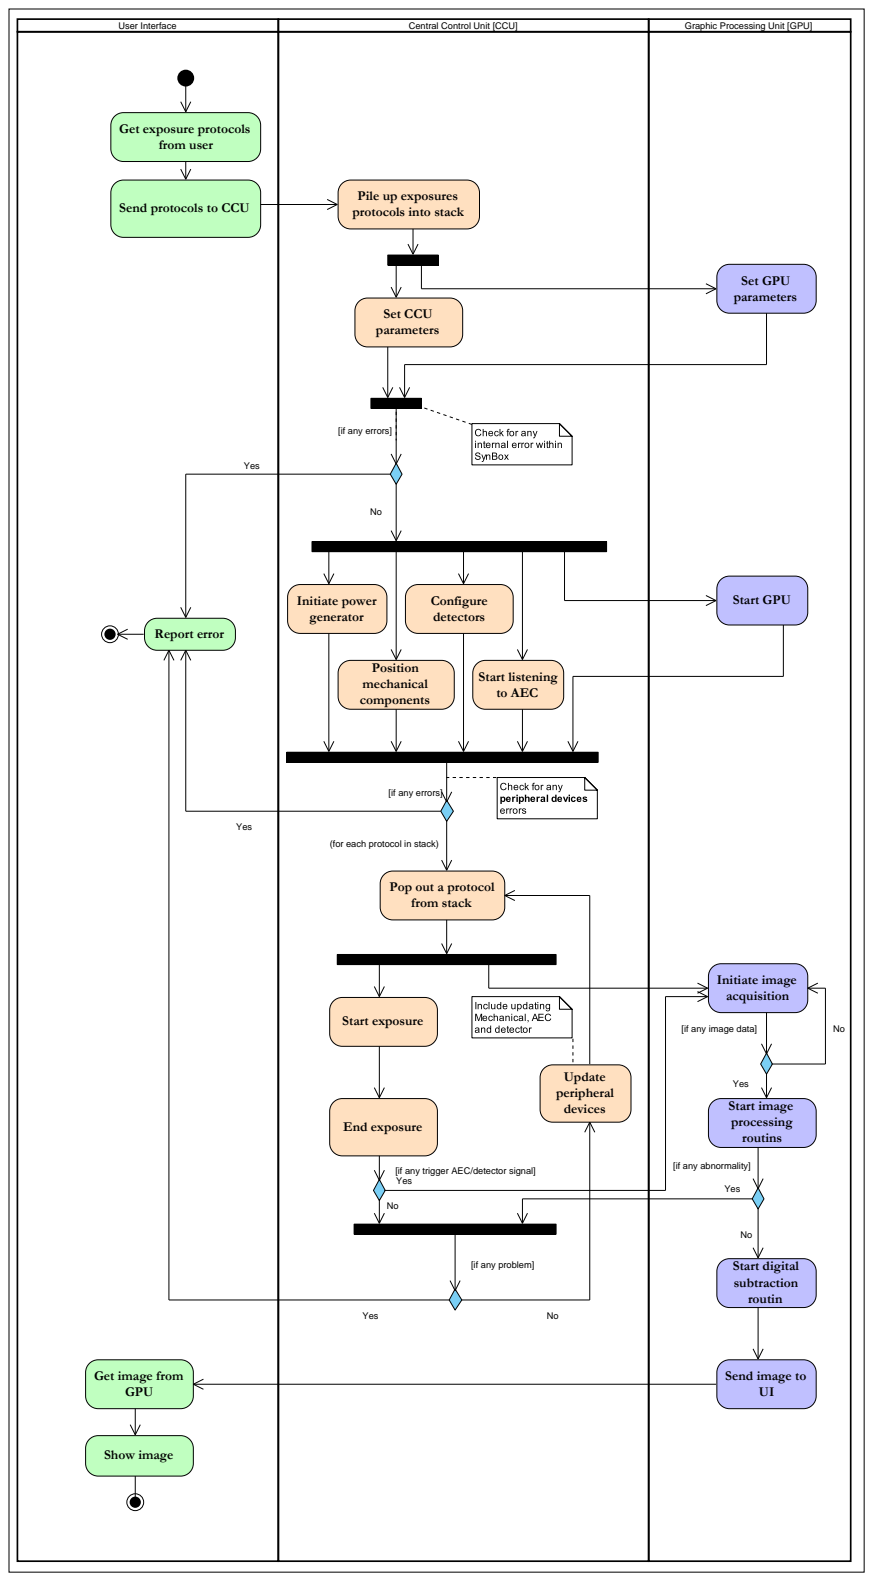
[picture p89: page 1]
User Interface; Central Control Unit [CCU]; Graphic Processing Unit [GPU]; from user; Set CCU parameters; Set GPU parameters; Report error; Initiate power generator; Configure detectors; Position mechanical; components; Start listening to AEC; Start GPU; Start exposure; Initiate image acquisition; Start image processing routins; Start digital subtraction routin; End exposure; Show image; Update peripheral devices; Yes; [if any image data]

Get exposure protocols

Pile up exposures
protocols into stack

Send protocols to CCU

[if any errors]

(for each protocol in stack)

Pop out a protocol
from stack

[if any trigger AEC/detector signal]
Yes

[if any abnormality]

[if any problem]

Get image from
GPU

Send image to UI
