GitForEng/syncbox/Artifacts/Reports/SyncBox/SyncBox Sequence Diagram.pdf

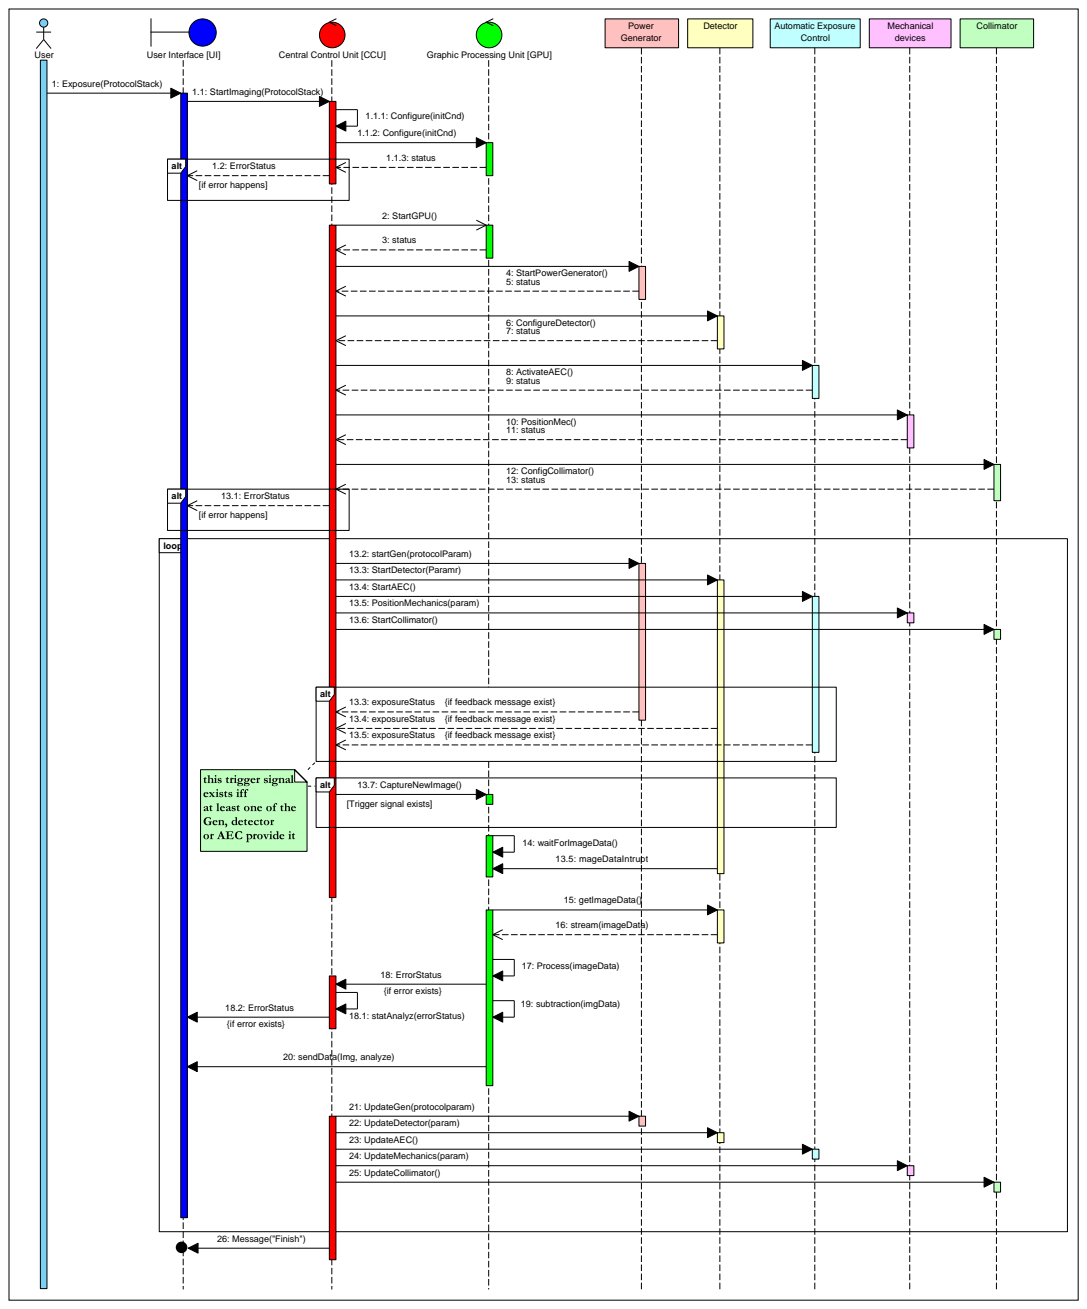
[picture p90: page 1]
loop; alt; Mechanical; Collimator; devices; Automatic Exposure Control; Power; Detector Generator; User; User Interface [UI]; Central Control Unit [CCU]; Graphic Processing Unit [GPU]; 18.2: ErrorStatus; 18.1: statAnalyz(errorStatus); 17: Process(imageData); 19: subtraction(imgData); 13.5: mageDataIntrupt; 14: waitForImageData(); 13.5: exposureStatus; 13.4: exposureStatus; 13.7: CaptureNewImage(); 13.1: ErrorStatus; 11: status; 9: status; 7: status; 5: status; 3: status; 10: PositionMec()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

alt
[if error happens]

12: ConfigCollimator() 13: status

13.2: startGen(protocolParam)
13.3: StartDetector(Paramr)
13.4: StartAEC()
13.5: PositionMechanics(param)
13.6: StartCollimator()

13.3: exposureStatus {if feedback message exist}

{if feedback message exist}

[Trigger signal exists]

15: getImageData()

16: stream(imageData)

18: ErrorStatus
{if error exists}

20: sendData(Img, analyze)

26: Message("Finish") | 21: UpdateGen(protocolparam)

22: UpdateDetector(param)
23: UpdateAEC()
24: UpdateMechanics(param)
25: UpdateCollimator()
