GitForEng/syncbox/(list of files, drawings)

Other design files:
Design/[01] - COVER PAGE.SchDoc
Design/[03] - MICRO CONTROLLER.SchDoc
Design/[04] - COMe CONNECTOR.SchDoc
Design/[05] - POWER.SchDoc
Design/[06] - MICRO CONTROLLER CONNECTORS.SchDoc
Design/[07] - CPU CONNECTORS .SchDoc
Design/[08] - CPU USB.SchDoc
Design/[09] - PCB AND MECHANICALS.SchDoc
Design/[10] - DOC REVISION HISTORY.SchDoc
Design/Syncbox.PrjPcb
Design/SYNCBOX.SchDoc
Design/SYNCBOX_V3I1.SCHLIB
Design/SYNCBOX_V3I1/SYNCBOX_V3I1_1.SCHLIB
