GitForEng/syncbox/Design/Firmware/PIC24 Firmware/firmware/Types.h

/**
 * \file Types.h
 * \brief global types ar defined here. These types are used to simplify the code clearance. 
 */
#ifndef TYPE_H
  #define TYPE_H
  typedef unsigned char byte;//!< \brief byte is unsigned char.
  typedef unsigned int uint;//!< \brief uint is unsigned int.
#endif
