GitForEng/syncbox/Design/Firmware/PIC24 Firmware/tests_tries/Unit test/ServoMotor/TestDeltaServoMotorConnector.c

//
//
//
// //SetUARTCallback(&ProcessGeneratorResponse);
// Sound_Play(659, 500);
// Delay_ms(500);
//
//
// // first turn off motor: may still on from previous unsuccessul terminated session.
// TurnOffSliderMotor();
// Sound_Play(850, 550);
//
//
// // turn on motor with no move
// TurnOnSliderMotor();
// Sound_Play(659, 250);   // Frequency = 659Hz, duration = 250ms
// Delay_ms(1000);
//
// // set speed
// SetSliderMotorSpeed(100);
// Sound_Play(700, 250);
// Delay_ms(3000);
//
// // Start Rotation
// RotateSliderMotorCounterClockwise();
// Sound_Play(750, 250);
// Delay_ms(4000);
// //--------------------------------------------------
//
//// increase speed step 1
// StopMotor();
// SetSliderMotorSpeed(200);
// RotateSliderMotorCounterClockwise();
// Sound_Play(700, 250);
// Delay_ms(3000);
//
//// increase speed step 2
// StopMotor();
// SetSliderMotorSpeed(300);
// RotateSliderMotorCounterClockwise();
// Sound_Play(700, 250);
// Delay_ms(3000);
//
// // increase speed step 4
// StopMotor();
// SetSliderMotorSpeed(400);
// RotateSliderMotorCounterClockwise();
// Sound_Play(700, 250);
// Delay_ms(3000);
//
// // increase speed step 5
// StopMotor();
// SetSliderMotorSpeed(500);
// RotateSliderMotorCounterClockwise();
// Sound_Play(700, 250);
// Delay_ms(3000);
//
//
//
//
// //SetSliderMotorSpeed(200);
//// Sound_Play(800, 250);
//// Delay_ms(3000);
////
//// SetSliderMotorSpeed(300);
//// Sound_Play(900, 250);
//// Delay_ms(3000);
////
//// SetSliderMotorSpeed(400);
//// Sound_Play(950, 250);
//// Delay_ms(3000);
////
//// SetSliderMotorSpeed(500);
//// Sound_Play(1000, 250);
//// Delay_ms(3000);
////
//// SetSliderMotorSpeed(600);
//// Sound_Play(1050, 250);
//// Delay_ms(3000);
////
//// SetSliderMotorSpeed(700);
//// Sound_Play(1100, 250);
//// Delay_ms(3000);
////
//// SetSliderMotorSpeed(800);
//// Sound_Play(1150, 250);
//// Delay_ms(3000);
////
// //RotateSliderMotorClockwise();
// TurnOffSliderMotor();
// Sound_Play(850, 550);
