GitForEng/syncbox/Design/Firmware/PIC24 Firmware/tests_tries/try_I2C/MASTER/resources.h

// TFT module connections
char TFT_DataPort at LATE;
sbit TFT_RST at LATD7_bit;
sbit TFT_BLED at LATD2_bit;
sbit TFT_RS at LATD9_bit;
sbit TFT_CS at LATD10_bit;
sbit TFT_RD at LATD5_bit;
sbit TFT_WR at LATD4_bit;
char TFT_DataPort_Direction at TRISE;
sbit TFT_RST_Direction at TRISD7_bit;
sbit TFT_BLED_Direction at TRISD2_bit;
sbit TFT_RS_Direction at TRISD9_bit;
sbit TFT_CS_Direction at TRISD10_bit;
sbit TFT_RD_Direction at TRISD5_bit;
sbit TFT_WR_Direction at TRISD4_bit;
// End TFT module connections

const code char HandelGothic_BT21x22_Regular[] = {
   0x00,
   0x00,
   0x20,0x00,
   0x7F,0x00,
   0x16,
   0x00,
   0x01,0x88,0x01,0x00,
   0x05,0x9E,0x01,0x00,
   0x06,0xB4,0x01,0x00,
   0x0E,0xCA,0x01,0x00,
   0x0E,0xF6,0x01,0x00,
   0x11,0x22,0x02,0x00,
   0x0F,0x64,0x02,0x00,
   0x03,0x90,0x02,0x00,
   0x06,0xA6,0x02,0x00,
   0x06,0xBC,0x02,0x00,
   0x09,0xD2,0x02,0x00,
   0x0E,0xFE,0x02,0x00,
   0x03,0x2A,0x03,0x00,
   0x06,0x40,0x03,0x00,
   0x03,0x56,0x03,0x00,
   0x08,0x6C,0x03,0x00,
   0x0E,0x82,0x03,0x00,
   0x04,0xAE,0x03,0x00,
   0x0C,0xC4,0x03,0x00,
   0x0B,0xF0,0x03,0x00,
   0x0F,0x1C,0x04,0x00,
   0x0C,0x48,0x04,0x00,
   0x0E,0x74,0x04,0x00,
   0x0C,0xA0,0x04,0x00,
   0x0D,0xCC,0x04,0x00,
   0x0D,0xF8,0x04,0x00,
   0x03,0x24,0x05,0x00,
   0x03,0x3A,0x05,0x00,
   0x0D,0x50,0x05,0x00,
   0x0D,0x7C,0x05,0x00,
   0x0D,0xA8,0x05,0x00,
   0x0D,0xD4,0x05,0x00,
   0x12,0x00,0x06,0x00,
   0x0F,0x42,0x06,0x00,
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
   0x00,0x00,0x00,0x00,0x00,0x00,0x8C,0x92,0x62,0x00,0x00,0x00,0x00,                // Code for char num 126
   0x00,0x00,0x00,0x00,0x00,0x00,0xFE,0x01,0x02,0x01,0x02,0x01,0x02,0x01,0x02,0x01,0x02,0x01,0x02,0x01,0xFE,0x01,0x00,0x00,0x00,0x00 // Code for char num 127
        };
