GitForEng/syncbox/Design/Firmware/PIC24 Firmware/bootloader/USB HID Bootloader/Projects/Common Files/Main.h

/******************************************************************************
 *                                                                            *
 *  Unit:         Main.h                                                      *
 *                                                                            *
 *  Copyright:    (c) Mikroelektronika, 2011.                                 *
 *                                                                            *
 *  Description:  Main.c declarations.                                        *
 *                                                                            *
 ****************************       CHANGE LOG       **************************
 * Version | ACTION                                           |  DATE  | SIG  *
 * --------|--------------------------------------------------|--------|----- *
 *         |                                                  |        |      *
 *    0.01 | - Initial release                                | 030511 |  ST  *
 *         |                                                  |        |      *
 ******************************************************************************/
#ifndef __MAIN
#define __MAIN

void main(void); // Main routine.
#endif
