GitForEng/syncbox/(commit log)

2022-01-19 new development board added
2022-01-19 firmware project initialized
    [Firmware.cfg]
2022-01-19 bootloader is added to firmware
    [USB HID Bootloader.cfg]
2022-01-19 touch screen firmware created
    [icon configuration.txt, touch configuration.txt]
2022-01-19 SyncBox prototype reports added
2022-01-23 new design files added
    [DelayTimerIntrrupt.cfg, I2CMASTER.cfg, I2CSlave.cfg, INT2.cfg, SMASeries.stp, SYNCBOX.SchDoc, SYNCBOX_V3I1.SCHLIB, SYNCBOX_V3I1_1.SCHLIB]
2022-01-23 microcontroller schematics updated
    [[03] - MICRO CONTROLLER.SchDoc]
2022-01-23 microcontroller updated
    [[03] - MICRO CONTROLLER.SchDoc]
2022-01-23 power schematics updated
    [[05] - POWER.SchDoc]
2022-01-23 mechanicals schematics updated
    [[09] - PCB AND MECHANICALS.SchDoc]
2022-01-23 release files updated
    [syncbox_copper_plane_1.gbr, syncbox_copper_plane_2.gbr, syncbox_copper_signal_1.gbr, syncbox_copper_signal_2.gbr, syncbox_copper_signal_bot.gbr, syncbox_copper_signal_top.gbr, syncbox_legend_bot.gbr, syncbox_legend_top.gbr]
